gavrd7/MakerVault-Hardware/THIRD_PARTY_NOTICES.md

# Third-party code and asset notices

## MakerVault-owned source

MakerVault-authored source code and documentation in this repository are offered under the **GNU Affero General Public License, version 3 (AGPL-3.0)**. See [LICENSE](LICENSE).

This does not override third-party copyright or licensing.

## QRCode library — MIT

The bundled `qrcode.c` and `qrcode.h` are from [Richard Moore's QRCode](https://github.com/ricmoo/QRCode), incorporating contributions attributed to Project Nayuki, under the MIT licence.

The full notice is retained in [QRCode-LICENSE.txt](firmware/rfid-terminal/third_party/QRCode-LICENSE.txt) and must accompany redistributions. MIT-licensed source may be redistributed as part of an AGPL project while retaining its own original notice.

## Arduino library and board dependencies

The firmware uses external libraries/cores installed separately through Arduino IDE. Their licences are **not** changed by this repository's AGPL licence. See [build instructions](firmware/rfid-terminal/BUILD.md).

## MakerVault artwork and enclosure models

The project maintainer confirms that the MakerVault logo was created specifically for MakerVault using ChatGPT, and that the enclosure design files and UI graphics in this repository were created for this project. No third-party icon packs or external artwork are knowingly included. These assets are distributed with the project under the stated licence to the extent the maintainer has rights to grant; this statement is not a guarantee of exclusive copyright in AI-generated content.

If externally sourced material is introduced in future, identify its source and licence separately before redistribution.
