gavrd7/MakerVault-Hardware/hardware/rfid-terminal/3MF/MakerVault_flush_wordmark_3color_revC.3mf

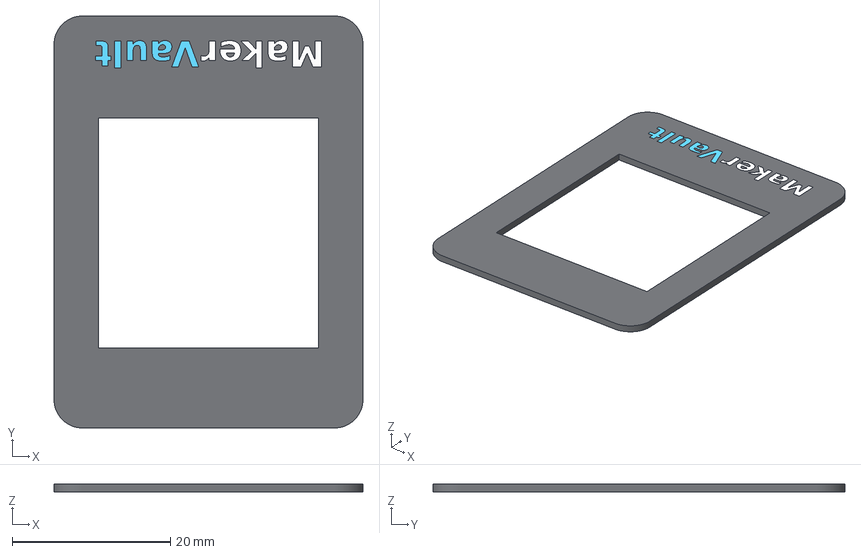
[picture p1: CAD file, 2026-10-25]
hardware/rfid-terminal/3MF/MakerVault_flush_wordmark_3color_revC.3mf
39.0 x 52.0 x 1.00 mm
flush_bezel_black
wordmark_white_Maker
wordmark_blue_Vault
