gavrd7/MakerVault-Hardware/hardware/rfid-terminal/STEPs/Bezel_3_Color_Components/flush_bezel_black.step

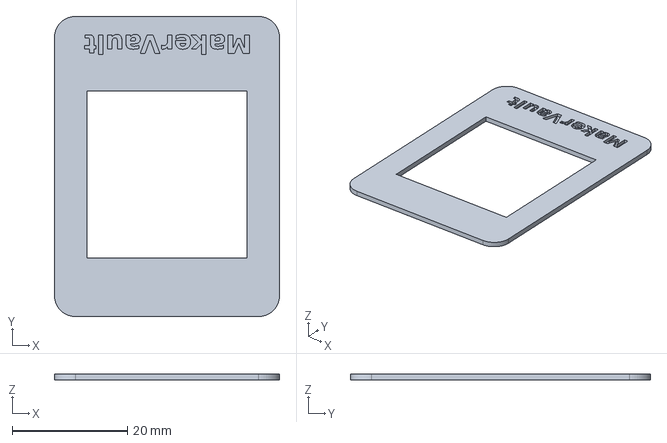
[picture p2: CAD file, 2026-10-25]
hardware/rfid-terminal/STEPs/Bezel_3_Color_Components/flush_bezel_black.step
39.0 x 52.0 x 1.00 mm
