gavrd7/MakerVault-Hardware/hardware/rfid-terminal/STEPs/display_carrier_revC.step

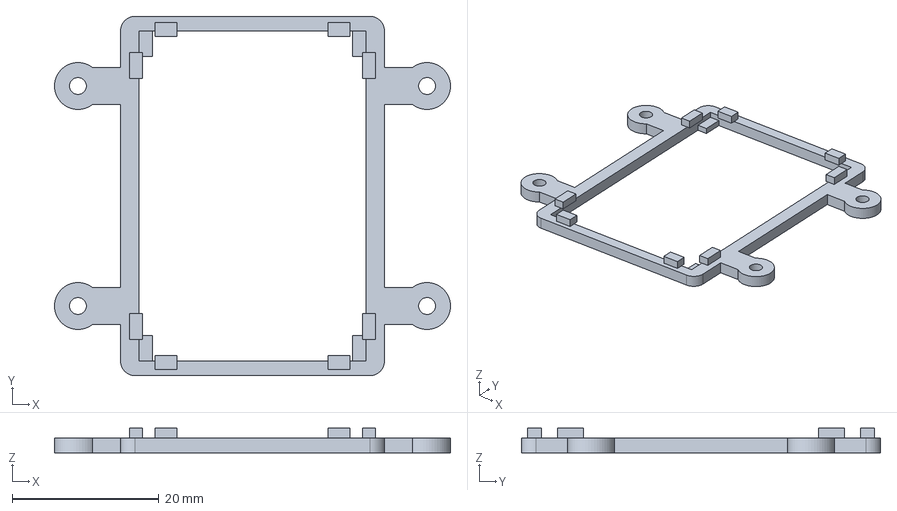
[picture p3: CAD file, 2026-10-25]
hardware/rfid-terminal/STEPs/display_carrier_revC.step
54.0 x 49.0 x 3.35 mm
