gavrd7/MakerVault-Hardware/hardware/rfid-terminal/STLs/Optional/switch_shim_0p4_revD.stl

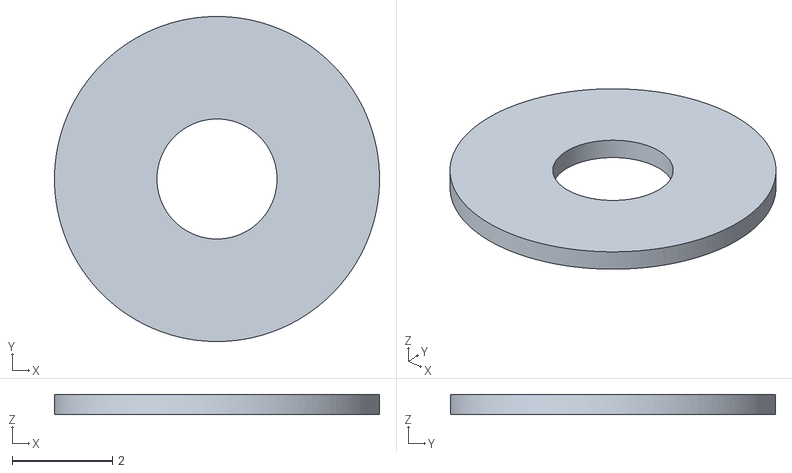
[picture p4: CAD file, 2026-10-25]
hardware/rfid-terminal/STLs/Optional/switch_shim_0p4_revD.stl
6.50 x 6.50 x 0.4
