gavrd7/MakerVault-Hardware/hardware/rfid-terminal/STEPs/Bezel_3_Color_Components/wordmark_white_Maker.step

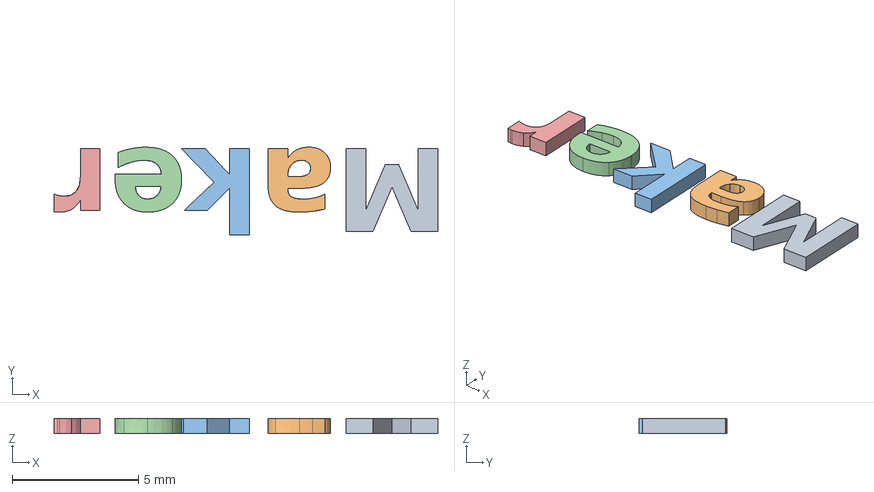
[picture p5: CAD file, 2026-10-25]
hardware/rfid-terminal/STEPs/Bezel_3_Color_Components/wordmark_white_Maker.step
15.2 x 3.48 x 0.6 mm
