gavrd7/MakerVault-Hardware/hardware/rfid-terminal/STEPs/encoder_knob_RevD.step

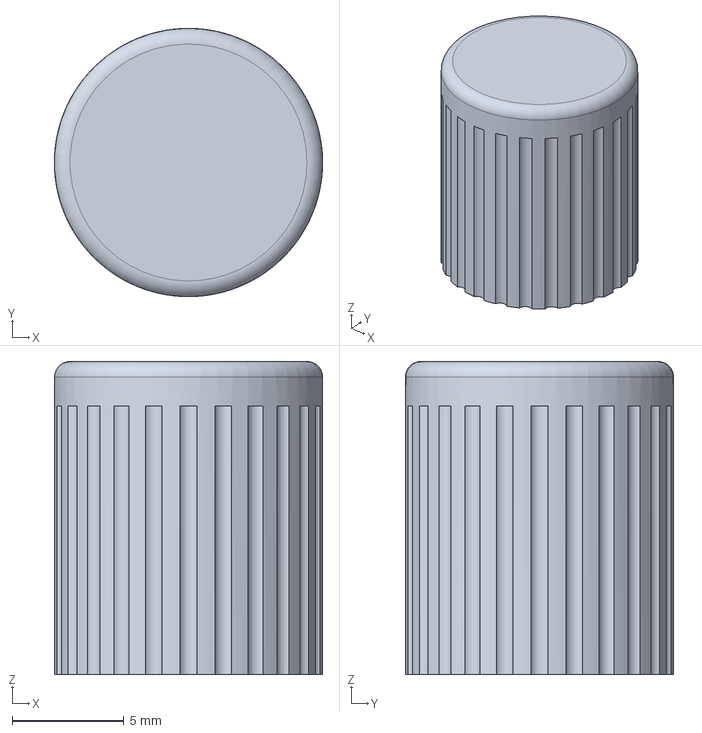
[picture p6: CAD file, 2026-10-25]
hardware/rfid-terminal/STEPs/encoder_knob_RevD.step
12.0 x 12.0 x 14.0 mm
