gavrd7/MakerVault-Hardware/hardware/rfid-terminal/STEPs/Bezel_3_Color_Components/wordmark_blue_Vault.step

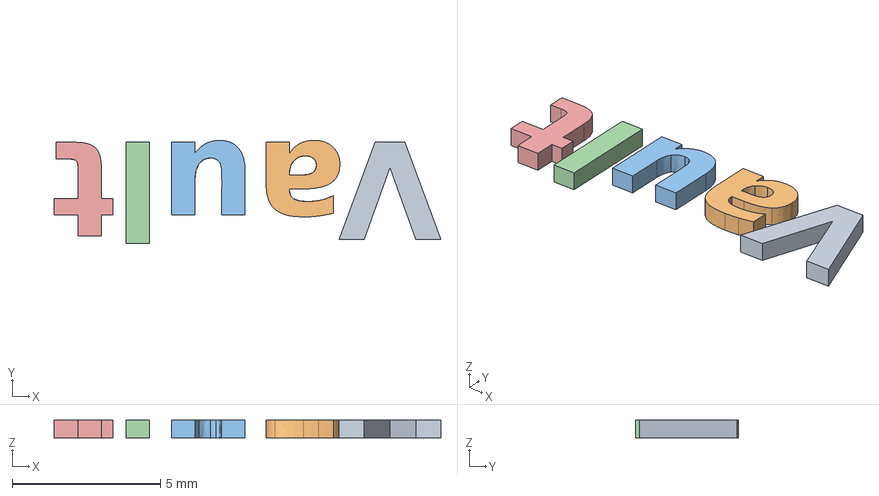
[picture p8: CAD file, 2026-10-25]
hardware/rfid-terminal/STEPs/Bezel_3_Color_Components/wordmark_blue_Vault.step
13.0 x 3.48 x 0.6 mm
