gavrd7/MakerVault-Hardware/hardware/rfid-terminal/STEPs/rear_shell_esp32_cradle_revC_m2.step

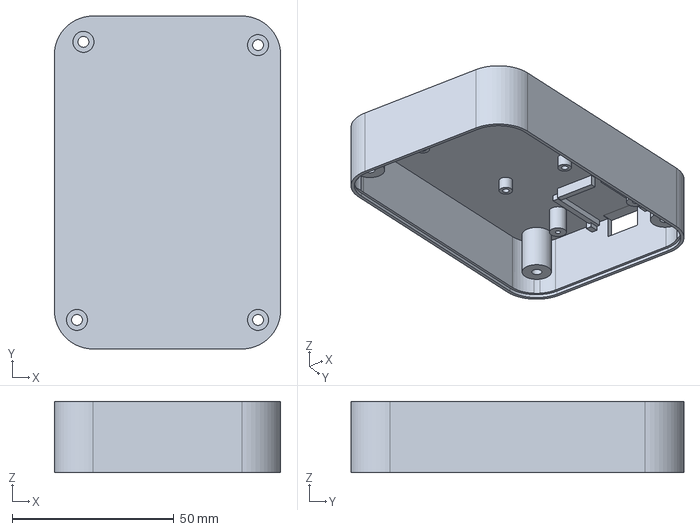
[picture p9: CAD file, 2026-10-25]
hardware/rfid-terminal/STEPs/rear_shell_esp32_cradle_revC_m2.step
70.0 x 103.0 x 22.0 mm
