gavrd7/MakerVault-Hardware/hardware/rfid-terminal/STEPs/usb_stop_bridge_revC_m2.step

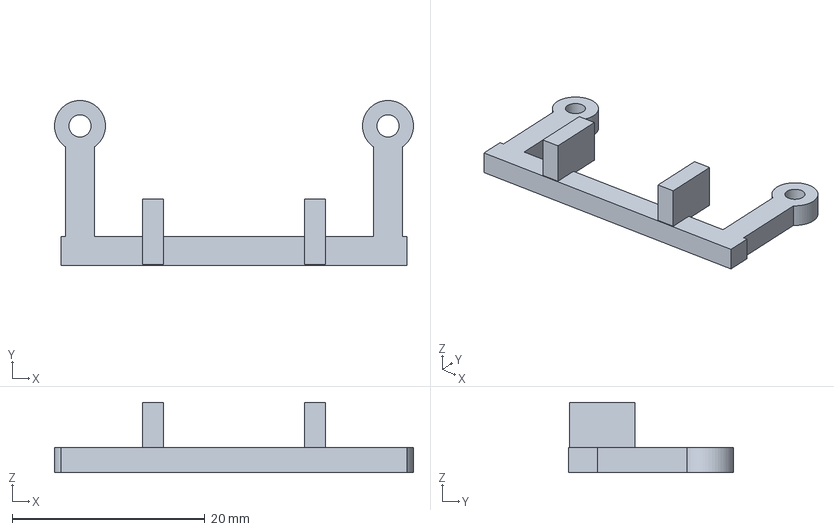
[picture p10: CAD file, 2026-10-25]
hardware/rfid-terminal/STEPs/usb_stop_bridge_revC_m2.step
37.3 x 17.1 x 7.30 mm
