gavrd7/MakerVault-Hardware/hardware/rfid-terminal/STEPs/front_shell_fastening_revC.step

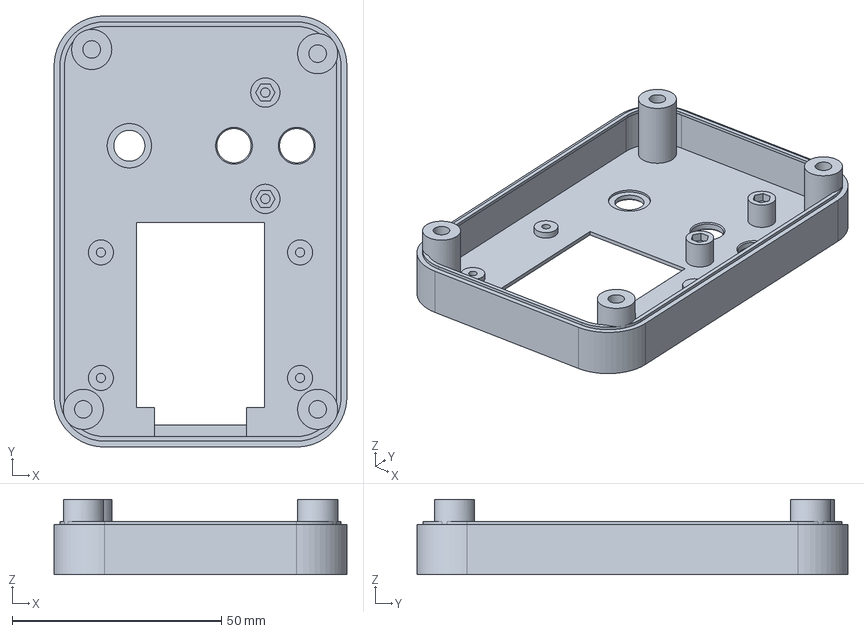
[picture p11: CAD file, 2026-10-25]
hardware/rfid-terminal/STEPs/front_shell_fastening_revC.step
70.0 x 103.0 x 18.0 mm
