gavrd7/MakerVault-Hardware/hardware/rfid-terminal/STEPs/open_switch_carrier_revE.step

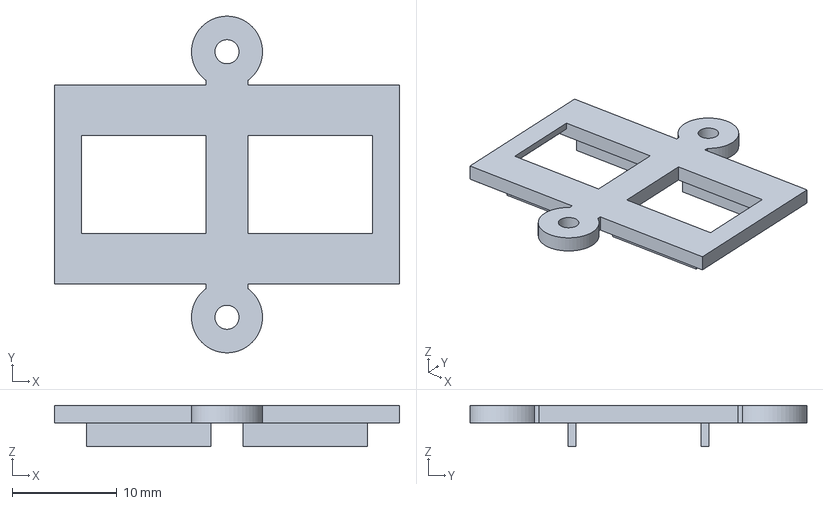
[picture p12: CAD file, 2026-10-25]
hardware/rfid-terminal/STEPs/open_switch_carrier_revE.step
33.0 x 32.2 x 3.95 mm
