gavrd7/MakerVault-Hardware/hardware/rfid-terminal/STEPs/button_cap_revD.step

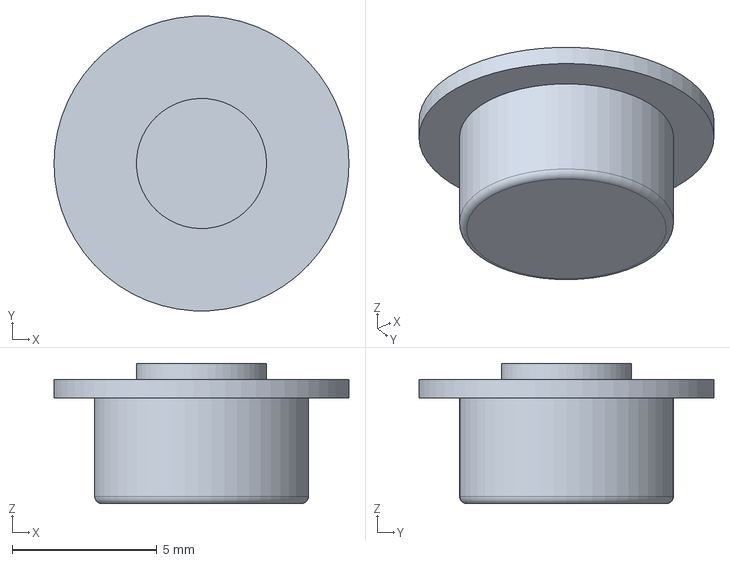
[picture p13: CAD file, 2026-10-25]
hardware/rfid-terminal/STEPs/button_cap_revD.step
10.2 x 10.2 x 4.85 mm
