gavrd7/MakerVault-Hardware/(list of files, cad)

Other CAD files:
hardware/rfid-terminal/STLs/Bezel_3_Color_Components/flush_bezel_black.stl
hardware/rfid-terminal/STLs/Bezel_3_Color_Components/wordmark_blue_Vault.stl
hardware/rfid-terminal/STLs/Bezel_3_Color_Components/wordmark_white_Maker.stl
hardware/rfid-terminal/STLs/button_cap_revD.stl
hardware/rfid-terminal/STLs/display_carrier_revC.stl
hardware/rfid-terminal/STLs/encoder_knob_RevD.stl
hardware/rfid-terminal/STLs/front_shell_fastening_revC.stl
hardware/rfid-terminal/STLs/open_switch_carrier_revE.stl
hardware/rfid-terminal/STLs/rear_shell_esp32_cradle_revC_m2.stl
hardware/rfid-terminal/STLs/usb_stop_bridge_revC_m2.stl
