gavrd7/MakerVault-Hardware/firmware/rfid-terminal/MakerVault_Terminal_Firmware/MakerVault_Terminal_Firmware.ino

#include <Arduino.h>
#include <SPI.h>
#include <Adafruit_GFX.h>
#include <Adafruit_ST7735.h>
#include <Adafruit_NeoPixel.h>
#include <MFRC522.h>
#include <WiFi.h>
#include <Fonts/FreeSansBold9pt7b.h>
#include <Fonts/FreeSansBold18pt7b.h>
#include "firmware_version.h"
#include "brand_images.h"
#include "ui_icons.h"
#include "provisioning.h"
#include "connected_registration.h"
#include "terminal_record_browser.h"
#include "scan_lookup.h"
#include "cfs_tag_reader.h"
#include "elegoo_tag_reader.h"
#include "bambu_tag_reader.h"
#include "cfs_material_labels.h"
#include "cfs_spool_lookup.h"
#include "remote_lookup.h"
#include "ntag215_feature_gate.h"
// NTAG215 NFC link writing is enabled in standard v0.7 builds.
#if MAKERVAULT_NDEF_WRITER_ENABLED
#include "connected_ndef_write.h"
#include "connected_makertag_operation.h"
#endif
#include "terminal_pending_work.h"
#include "memory_recovery_policy.h"

// MakerVault handheld UI v0.8 development -- ESP32-S3 SuperMini, Rev C.3
// Shared hardware SPI, read-only RFID, all original GPIO assignments.
constexpr uint8_t SCK_PIN=12, MOSI_PIN=11, MISO_PIN=13;
constexpr uint8_t TFT_CS=1, TFT_DC=2, TFT_RST=43;
constexpr uint8_t RFID_CS=10, RFID_RST=9;
constexpr uint8_t ENC_A=4, ENC_B=5, ENC_SW=6;
constexpr uint8_t BACK_PIN=7, CONFIRM_PIN=8, RGB_PIN=48;
Adafruit_ST7735 tft(&SPI,TFT_CS,TFT_DC,TFT_RST);
Adafruit_GFX *display = &tft; // Hardware TFT; no temporary screenshot buffer
MFRC522 rfid(RFID_CS,RFID_RST);
Adafruit_NeoPixel led(1,RGB_PIN,NEO_GRB+NEO_KHZ800);

// RGB565 palette, crafted for a small TFT.
constexpr uint16_t BG=0x0843, CARD=0x10C6, NAVY=0x10ED,
  BLUE=0x159F, SKY=0x867F, WHITE=0xFFFF, SILVER=0xCE79,
  MUTED=0x94D2, GREEN=0x464C, AMBER=0xF5A2, LINE=0x296A;

// Development MakerTag creation uses the server-authorised registration/NDEF
// lifecycle; generic RFID writing remains intentionally unavailable.
// This feature branch enables the new MakerTag browser for staged hardware
// testing. The released main-branch v0.7 firmware remains unchanged.
constexpr bool MAKERTAG_CREATE_IMPLEMENTED=true, RFID_WRITE_IMPLEMENTED=false;
enum Page:uint8_t{HOME,SCAN,RECENT,CONTROLS,INFO,CONNECTIONS,SETUP_WIFI,KNOWN_WIFI,DELETE_WIFI,MAKERVAULT_SETUP,MV_STATUS,MV_RECONNECT,MV_PAIR,MAKERTAGS_MENU,RFID_MENU,UNAVAILABLE,WIFI_MENU,MV_MENU,MV_FORGET,WIFI_STATUS,MV_TLS_TEST,MV_CA_REMOVE,REGISTRATION,LOOKUP_REQUEST,NDEF_WRITE,TAG_OPERATION,RB_CATEGORIES,RB_LIST,RB_LETTER,RB_PREVIEW};
Page page=HOME;
const char* choices[]={"MakerTags","RFID Tags","Connections","System info"};
int subSelected=0, detailScroll=0, detailCount=0;
String unavailableTitle="";
int selected=0;
int connSelected=0,networkSelected=0;
int wifiSelected=0,mvSelected=0;
uint8_t shownWifiState=255,shownMvState=255;uint32_t footerChecked=0;
String pendingDeleteSSID="";
// Persist manual offline mode independently of remembered SSIDs.

bool scanResultVisible=false, hasScanned=false, knownReader=false;
// The physical reader is shared, but each menu has distinct result semantics.
bool scanMakerTagsMode=true;
// CFS material preview is read-only and shown only in the generic RFID scan.
bool cfsDetected=false;
bool elegooDetected=false;
bool bambuDetected=false;
BambuTag::Material bambuMaterial={};
ElegooTag::Material elegooMaterial={};
CfsTag::Material cfsMaterial={};
uint8_t versionReg=0;
String recentUid="", recentType="";
uint32_t lastPoll=0,feedbackUntil=0;
bool readerInitDone=false; bool readerBusVerified=false; uint32_t bootAt=0;
uint32_t lastInputAt=0;
const int8_t decode[16]={0,-1,1,0,1,0,0,-1,-1,0,0,1,0,1,-1,0};
uint8_t previousAB=0;
int8_t stepCount=0;
uint32_t lastEncoderTurnAt=0;

struct Key {
 uint8_t pin; bool raw=true,stable=true;uint32_t changed=0;
 void begin(uint8_t p){pin=p;pinMode(pin,INPUT_PULLUP);raw=stable=digitalRead(pin);changed=millis();}
 bool pressed(){bool next=digitalRead(pin);if(next!=raw){raw=next;changed=millis();}
   if((uint32_t)(millis()-changed)>=35 && next!=stable){stable=next;return !stable;}return false;}
};
Key selectKey,backKey,confirmKey;

void asset(int x,int y,const uint16_t* image,int w,int h){display->drawRGBBitmap(x,y,image,w,h);}
void textAt(int x,int y,const char* label,uint16_t color,uint8_t size=1){
 display->setTextWrap(false);display->setTextSize(size);display->setTextColor(color);display->setCursor(x,y);display->print(label);
}
void bottom(const char* hint){
 display->fillRect(0,114,128,14,BG);display->drawFastHLine(5,113,118,LINE);
 textAt(7,118,hint,MUTED);
}
void header(const char* label){
 display->fillRect(0,0,128,24,BG);
 display->fillRoundRect(5,4,20,20,3,WHITE);
 asset(5,4,SMALL_ICON,20,20);
 textAt(31,8,label,WHITE);
 display->drawFastHLine(5,26,118,LINE);
}
void splash(){
  display->fillScreen(BG);
  // Layout is fixed to the visible 128 x 128 ST7735 viewport.
  // Leave distinct vertical bands for the logo, name and subtitle.
  display->fillRoundRect(27,3,74,74,7,WHITE);
  asset(29,5,BRAND_ICON,70,70);

  const char* first="Maker";
  const char* second="Vault";
  display->setFont(&FreeSansBold9pt7b);
  display->setTextSize(1);
  int16_t ax,ay,bx,by;
  uint16_t aw,ah,bw,bh;
  display->getTextBounds(first,0,0,&ax,&ay,&aw,&ah);
  display->getTextBounds(second,0,0,&bx,&by,&bw,&bh);
  const int16_t total=(int16_t)aw+(int16_t)bw;
  const int16_t x=(128-total)/2;
  const int16_t baseline=96;
  if(total<=122){
    display->setTextColor(WHITE);
    display->setCursor(x-ax,baseline);
    display->print(first);
    display->setTextColor(SKY);
    display->setCursor(x+(int16_t)aw-bx,baseline);
    display->print(second);
  }else{
    // Unexpected font metrics: use the native 6x8 font rather than crop.
    display->setFont(NULL);
    const int16_t nativeX=(128-10*6)/2;
    textAt(nativeX,85,first,WHITE);
    textAt(nativeX+5*6,85,second,SKY);
  }
  display->setFont(NULL);
  // 19 characters in Adafruit's default 6px font = 114px.
  // Derive the origin from measured bounds rather than a fixed X.
  const char* subtitle="RFID / NFC TERMINAL";
  int16_t sx,sy;uint16_t sw,sh;
  display->setTextSize(1);
  display->getTextBounds(subtitle,0,0,&sx,&sy,&sw,&sh);
  textAt((128-(int16_t)sw)/2-sx,107,subtitle,MUTED);
  display->drawRoundRect(18,120,92,4,2,LINE);
  display->fillRoundRect(19,121,90,2,1,BLUE);
  delay(380);
}

// Material-inspired raster assets are the sole icon source. Tint the 15x15
// status icons without restoring the old pixel-art line drawings.
// The source artwork uses a dark background and light foreground. Preserve
// antialiased edge coverage by scaling the requested RGB565 status colour.
void tintedIcon(int x,int y,const uint16_t* pixels,int width,int height,uint16_t tint){
 const uint8_t tr=((tint>>11)&31),tg=((tint>>5)&63),tb=(tint&31);
 for(int j=0;j<height;j++)for(int i=0;i<width;i++){
  uint16_t px=pgm_read_word(pixels+j*width+i);
  // Icon pixel brightness: near-background becomes transparent.
  uint8_t r=(px>>11)&31,g=(px>>5)&63,b=px&31;
  int coverage=max((int)r*2,max((int)g,(int)b*2))-6;
  if(coverage<0)coverage=0;
  if(coverage>58)coverage=58;
  if(coverage>2){
   const int br=(BG>>11)&31,bg=(BG>>5)&63,bb=BG&31;
   uint16_t out=(((br*(58-coverage)+tr*coverage)/58)<<11)|
                (((bg*(58-coverage)+tg*coverage)/58)<<5)|
                 ((bb*(58-coverage)+tb*coverage)/58);
   display->drawPixel(x+i,y+j,out);
  }
 }
}
void wifiStatusIcon(int x,int y,uint16_t c){tintedIcon(x,y,MV_WIFI_FOOTER,15,15,c);}
void mvStatusIcon(int x,int y,uint16_t c){tintedIcon(x,y,MV_SERVER_FOOTER,15,15,c);}
void centeredAt(int y,const char *label,uint16_t color){
 int16_t x0,y0;uint16_t w,h;
 display->getTextBounds(label,0,y,&x0,&y0,&w,&h);
 textAt((128-(int)w)/2-x0,y,label,color);
}
// Shared text layout: word wrap, character fallback for URLs, and scrollable details.
// Content occupies y=31..109; top header and bottom navigation remain fixed.
const int CONTENT_TOP=32, CONTENT_BOTTOM=109, ROW_H=12, MAX_LINES=64;
struct DetailLine {String content;uint16_t ink;};
DetailLine detailLines[MAX_LINES];
void detailClear(){detailCount=0;}
void detailLine(const String &line,uint16_t color){
 if(detailCount<MAX_LINES)detailLines[detailCount++]={line,color};
}
void detailWrapped(const String &raw,uint16_t color,int width=114){
 String word="",line="";
 auto flushWord=[&](){
  if(!word.length())return;
  while(word.length()){
   String candidate=line+word;int16_t xx,yy;uint16_t ww,hh;
   display->setTextSize(1);display->getTextBounds(candidate.c_str(),0,0,&xx,&yy,&ww,&hh);
   if(ww<=width){line=candidate;word="";break;}
   if(line.length()){detailLine(line,color);line="";continue;}
   String chunk="";
   while(word.length()){
    String test=chunk+word[0];display->getTextBounds(test.c_str(),0,0,&xx,&yy,&ww,&hh);
    if(ww>width && chunk.length())break;
    chunk+=word[0];word.remove(0,1);
   }
   detailLine(chunk,color);
  }
 };
 for(size_t i=0;i<raw.length();i++){
  char ch=raw[i];
  if(ch=='\n'){flushWord();detailLine(line,color);line="";continue;}
  if(ch==' '){flushWord();if(line.length())line+=' ';}else word+=ch;
 }
 flushWord();if(line.length())detailLine(line,color);
}
void detailPaint(const char* title,bool full=true){
 if(full){display->fillScreen(BG);header(title);}
 else display->fillRect(0,CONTENT_TOP,128,CONTENT_BOTTOM-CONTENT_TOP+1,BG);
 const int visible=(CONTENT_BOTTOM-CONTENT_TOP)/ROW_H;
 int maxScroll=max(0,detailCount-visible);
 detailScroll=constrain(detailScroll,0,maxScroll);
 for(int i=0;i<visible && i+detailScroll<detailCount;i++){
  int y=CONTENT_TOP+i*ROW_H;
  textAt(6,y,detailLines[i+detailScroll].content.c_str(),detailLines[i+detailScroll].ink);
 }
 if(maxScroll){
  display->drawFastVLine(124,CONTENT_TOP,CONTENT_BOTTOM-CONTENT_TOP,LINE);
  int thumb=max(8,(CONTENT_BOTTOM-CONTENT_TOP)*visible/detailCount);
  int yy=CONTENT_TOP+(CONTENT_BOTTOM-CONTENT_TOP-thumb)*detailScroll/maxScroll;
  display->fillRoundRect(123,yy,4,thumb,2,SKY);
 }
 bottom(page==NDEF_WRITE && ndefState==9 ? "Back        Confirm" : (maxScroll?"Turn: scroll  Back":"Back: menu"));
}
void detailMove(int direction,const char* title){
 int visible=(CONTENT_BOTTOM-CONTENT_TOP)/ROW_H;
 int newScroll=constrain(detailScroll+direction,0,max(0,detailCount-visible));
 if(newScroll==detailScroll)return;
 detailScroll=newScroll;detailPaint(title,false);
}
void categoryRow(int i,const char* label){
 int y=42+i*29;
 display->fillRect(4,y,120,26,BG);
 if(!label[0])return;
 display->fillRoundRect(5,y,118,25,5,i==subSelected?NAVY:CARD);
 if(i==subSelected)display->fillRoundRect(5,y+4,3,17,1,SKY);
 textAt(13,y+9,label,i==subSelected?WHITE:SILVER);
}
void categoryPage(const char* title,const char* first,const char* second){
 display->fillScreen(BG);header(title);
 const char* labels[]={first,second};
 for(int i=0;i<2;i++){
  if(!labels[i][0])continue; // hide scoped actions until supported and granted
  categoryRow(i,labels[i]);
 }
 bottom("OK: open Back: home");
}
void menuGlyph(int idx,int x,int y,bool active){
 const uint16_t* iconsA[]={MV_SCAN_ACTIVE,MV_RECENT_ACTIVE,MV_CONNECTIONS_ACTIVE,MV_INFO_ACTIVE};
 const uint16_t* iconsB[]={MV_SCAN_INACTIVE,MV_RECENT_INACTIVE,MV_CONNECTIONS_INACTIVE,MV_INFO_INACTIVE};
 asset(x,y,active?iconsA[idx]:iconsB[idx],16,16);
}
void menuItem(int index){
 int y=32+index*20;bool active=index==selected;
 display->fillRect(3,y,122,19,BG);
 display->fillRoundRect(4,y,120,18,4,active?NAVY:CARD);
 if(active)display->fillRoundRect(4,y+3,3,12,1,SKY);
 menuGlyph(index,12,y+1,active);
 textAt(35,y+6,choices[index],active?WHITE:SILVER);
 if(active){display->drawLine(113,y+6,117,y+9,SKY);display->drawLine(117,y+9,113,y+12,SKY);}
}
bool readerReady(){return readerBusVerified || hasScanned;}
const char* readerLabel(){
 if(readerReady())return "Reader ready";
 if(readerInitDone)return "Reader check";
 return "Starting reader";
}
void home(){
 display->fillScreen(BG);header("MakerVault");
 for(int i=0;i<4;i++)menuItem(i);
 // Bottom bar: only the three status icons and short labels; no clipping.
 display->fillRect(0,113,128,15,BG);display->drawFastHLine(5,112,118,LINE);
 display->fillCircle(8,121,3,readerReady()?GREEN:(readerInitDone?AMBER:MUTED));
 textAt(14,118,"RFID",SILVER);
 // Live, colour-coded icons. The older bitmap artwork was permanently grey.
 wifiStatusIcon(51,113,WiFi.status()==WL_CONNECTED?GREEN:(knownCount?AMBER:MUTED));
 mvStatusIcon(86,113,mvCheckState==3?GREEN:(mvCheckState==2?AMBER:(mvCheckState==4?0xF800:MUTED)));
 // Connection details live in the Connections screen.
 shownWifiState=255;shownMvState=255;
}
void refreshFooter(){
 if(page!=HOME)return;
 uint8_t wifiState=WiFi.status()==WL_CONNECTED?2:(knownCount?1:0);
 uint8_t mvState=mvCheckState;
 if(wifiState==shownWifiState && mvState==shownMvState)return;
 shownWifiState=wifiState;shownMvState=mvState;
 display->fillRect(49,113,17,15,BG);display->fillRect(84,113,17,15,BG);
 wifiStatusIcon(51,113,wifiState==2?GREEN:(wifiState==1?AMBER:MUTED));
 mvStatusIcon(86,113,mvState==3?GREEN:(mvState==2?AMBER:(mvState==4?0xF800:MUTED)));
}
void simple(const char* title,const char* line1,const char* line2=""){
 display->fillScreen(BG);header(title);
 display->fillRoundRect(7,36,114,62,7,CARD);
 textAt(13,54,line1,WHITE);
 if(line2[0])textAt(13,72,line2,MUTED);
 bottom("Back: menu");
}
// Draw a prominent record identity, then the MakerVault ID; UID is secondary.
// Declared here because the scan screen reuses the record name wrapping helper.
int regWrapLines(const String &source, String *lines);
// Keep tag identity fields within the 128px viewport. Two short rows
// accommodate long MFRC522 family names without clipping or truncating UID.
void scanTypeWrapped(int y, uint16_t color){
 String value=recentType;
 const int maxChars=19; // 128px - 14px margins, 6px per character
 if(value.length()<=maxChars){centeredAt(y,value.c_str(),color);return;}
 int split=value.lastIndexOf(' ',maxChars);
 if(split<6)split=maxChars;
 String first=value.substring(0,split);
 String second=value.substring(split);
 second.trim();
 centeredAt(y,first.c_str(),color);
 if(second.length()>maxChars)second=second.substring(0,maxChars-1)+"~";
 centeredAt(y+12,second.c_str(),color);
}
void scanPage(){
 display->fillScreen(BG);
 if(!scanResultVisible){
  header(scanMakerTagsMode?"Scan MakerTag":"Scan RFID Tag");
  display->fillRoundRect(9,32,110,76,9,CARD);
  display->drawRoundRect(9,32,110,76,9,BLUE);
  asset(41,37,MV_SCAN_LARGE,46,46);
  centeredAt(78,"READY TO SCAN",WHITE);
  centeredAt(92,scanMakerTagsMode?"Present MakerTag":"Present RFID tag",SKY);
  bottom("Back: menu");return;
 }
 header(scanMakerTagsMode?"MakerTag scan":(cfsDetected?"CFS material":elegooDetected?"Elegoo (test)":bambuDetected?"Bambu (test)":"RFID scan"));
 if(!scanMakerTagsMode && bambuDetected){
  centeredAt(35,bambuMaterial.material,WHITE);
  centeredAt(49,bambuMaterial.detail,WHITE);
  display->fillRoundRect(42,58,44,11,4,CfsTag::hexRgb565(bambuMaterial.color));
  display->drawRoundRect(42,58,44,11,4,WHITE);
  centeredAt(79,(String("#")+bambuMaterial.color).c_str(),SKY);
  centeredAt(91,(String(bambuMaterial.weightGrams)+"g / "+bambuMaterial.materialId).c_str(),SILVER);
  centeredAt(103,recentUid.substring(0,19).c_str(),SILVER);
  bottom("Experimental / UID");return;
 }
 if(!scanMakerTagsMode && elegooDetected){
  centeredAt(38,(String(elegooMaterial.material)+" "+elegooMaterial.subtype).c_str(),WHITE);
  display->fillRoundRect(42,52,44,11,4,CfsTag::hexRgb565(elegooMaterial.color));
  display->drawRoundRect(42,52,44,11,4,WHITE);
  centeredAt(73,(String("#")+elegooMaterial.color).c_str(),SKY);
  centeredAt(88,(String(elegooMaterial.weightGrams)+"g / "+
             String(elegooMaterial.diameterHundredths/100.0f,2)+"mm").c_str(),SILVER);
  centeredAt(103,recentUid.substring(0,19).c_str(),SILVER);
  bottom("Experimental / UID");return;
 }
 if(!scanMakerTagsMode && cfsDetected){
  // Name comes from MakerVault; offline we display only data decoded from the tag.
  if(cfsMaterialLookupState==2 && cfsMaterialName.length()){
   String manufacturer=cfsMaterialManufacturer;
   if(manufacturer.length()>19)manufacturer=manufacturer.substring(0,18)+"~";
   centeredAt(31,manufacturer.c_str(),WHITE);
   String friendly=cfsMaterialName;
   if(friendly.length()>19)friendly=friendly.substring(0,18)+"~";
   centeredAt(44,friendly.c_str(),WHITE);
  }else{
   centeredAt(31,cfsMaterialLookupState==1?"Checking server...":cfsMaterialLookupState==4?"Connect for name":"Unknown material",SILVER);
   centeredAt(44,(String("ID ")+cfsMaterial.materialId).c_str(),WHITE);
  }
  // Compact, rounded rectangular swatch on one line, using the tag's actual hex.
  display->fillRoundRect(42,58,44,11,4,CfsTag::hexRgb565(cfsMaterial.color));
  display->drawRoundRect(42,58,44,11,4,WHITE);
  centeredAt(78,(String("#")+cfsMaterial.color).c_str(),SKY);
  if(cfsLookupState==2)
   centeredAt(90,(String("Spool: ")+cfsLookupSpool).substring(0,20).c_str(),GREEN);
  else if(cfsLookupState==3)centeredAt(90,"Spool not linked",AMBER);
  else if(cfsLookupState==4)centeredAt(90,"Lookup unavailable",AMBER);
  else centeredAt(90,"Checking spool...",SILVER);
  centeredAt(102,recentUid.substring(0,19).c_str(),SILVER);
  bottom("Confirm: rescan");return;
 }
 if(!scanMakerTagsMode && scanLookupState==2){
  centeredAt(55,"MakerTag found",GREEN);
  centeredAt(75,"Use Scan MakerTag",SKY);
 }else if(scanLookupState==2){
  String nameLines[20];
  int count=regWrapLines(scanLookupName,nameLines);
  int maxLines=min(3,count);
  for(int i=0;i<maxLines;i++)textAt(7,36+i*13,nameLines[i].c_str(),WHITE);
  // The full identifier must fit: MV- plus eight hex chars.
  textAt(7,79,scanLookupCode.c_str(),SKY);
 }else if(scanLookupState==3 && !scanMakerTagsMode){
  centeredAt(45,"RFID detected",GREEN);
  scanTypeWrapped(61,WHITE);
  centeredAt(84,"Not a MakerTag",SILVER);
 }else if(scanLookupState==3){
  // Material-style unknown identity: filled amber status disc with a
  // high-contrast white help glyph, rather than an outlined circle.
  display->fillCircle(64,48,16,AMBER);
  textAt(58,40,"?",WHITE,2);
  // Restore normal text size before centeredAt measures the label bounds.
  display->setTextSize(1);
  centeredAt(73,"Not MakerTag",AMBER);
 }else if(scanLookupState==1){
  centeredAt(62,"Checking tag...",SKY);
 }else if(scanLookupState==4){
  centeredAt(48,"Lookup unavailable",AMBER);
  if(!scanMakerTagsMode)scanTypeWrapped(63,SILVER);
 }else{
  centeredAt(37,"TAG READ",GREEN);
  scanTypeWrapped(60,SILVER);
 }
 // UID remains visible, small and lower priority.
 textAt(7,97,recentUid.substring(0,19).c_str(),SILVER);
 bottom("Confirm: rescan");
}
void remoteLookupScreen(){
 display->fillScreen(BG);header("Find MakerTag");
 if(remoteLookupState==1){
  centeredAt(48,"Request received",GREEN);
  centeredAt(68,"Present a tag",SKY);
  bottom("Back: dismiss");
 }else if(remoteLookupState==2){
  centeredAt(60,"Looking up...",SKY);
  bottom("Please wait");
 }else if(remoteLookupState==3){
  centeredAt(48,"Lookup complete",GREEN);
  centeredAt(68,"Check MakerVault",SKY);
  bottom("Back: menu");
 }else{
  centeredAt(48,"Lookup failed",AMBER);
  textAt(7,71,remoteLookupError.substring(0,19).c_str(),SILVER);
  bottom("Back: menu");
 }
}
void connectionRow(int i){
 const char* menu[]={"Wi-Fi","MakerVault"};
 {
  int y=43+i*31;
  display->fillRect(5,y,118,27,BG);
  display->fillRoundRect(6,y,116,26,4,i==connSelected?NAVY:CARD);
  if(i==connSelected)display->fillRoundRect(6,y+3,3,20,1,SKY);
  if(i==0)wifiStatusIcon(11,y+4,WiFi.status()==WL_CONNECTED?GREEN:AMBER);
  else mvStatusIcon(11,y+4,mvPairVerified&&mvCheckState==3?GREEN:(mvCheckState==4?0xF800:AMBER));
  textAt(38,y+9,menu[i],i==connSelected?WHITE:SILVER);
 }
}
void connections(){
 display->fillScreen(BG);header("Connections");
 for(int i=0;i<2;i++)connectionRow(i);
 bottom("OK: open Back: home");
}
const int WIFI_MENU_COUNT=5;
const char* wifiOption(int i){
 if(i==0)return wifiManualOffline?"Connect":(WiFi.status()==WL_CONNECTED?"Disconnect":"Connect");
 if(i==1)return "Connection status";
 if(i==2)return "Known networks";
 if(i==3)return "Add network";
 return "Reconnect";
}
void wifiRow(int i){
 int y=51+i*12;
 display->fillRect(5,y,118,12,BG);
 if(i==wifiSelected)display->fillRoundRect(5,y,118,12,3,NAVY);
 textAt(10,y+2,wifiOption(i),i==wifiSelected?WHITE:SILVER);
}
void wifiMenu(){
 display->fillScreen(BG);header("Wi-Fi");
 textAt(7,31,wifiManualOffline?"Manually offline":(WiFi.status()==WL_CONNECTED?"Connected":"Offline"),WiFi.status()==WL_CONNECTED?GREEN:AMBER);
 String network=WiFi.status()==WL_CONNECTED?WiFi.SSID():"No active network";
 if(network.length()>19)network=network.substring(0,18)+"~";
 textAt(7,43,network.c_str(),SILVER);
 for(int i=0;i<WIFI_MENU_COUNT;i++)wifiRow(i);
 bottom("OK: open Back: menu");
}
// Values are read from the active Wi-Fi interface, never cached as a past lease.
String currentIpAddress(){
 return WiFi.status()==WL_CONNECTED?WiFi.localIP().toString():String("Not connected");
}
void wifiStatusPage(){
 const bool connected=WiFi.status()==WL_CONNECTED;
 detailClear();detailScroll=0;
 detailWrapped(String("Connection: ")+(connected?"Connected":(wifiManualOffline?"Manually offline":"Disconnected")),connected?GREEN:AMBER);
 detailWrapped("SSID: "+(connected?WiFi.SSID():String("Not connected")),SILVER);
 detailWrapped("IP address: "+currentIpAddress(),connected?WHITE:SILVER);
 if(connected)detailWrapped("Signal: "+String(WiFi.RSSI())+" dBm",SILVER);
 else detailWrapped("Signal: unavailable",MUTED);
 detailPaint("Wi-Fi status");
}
void makerRow(int i){
 const char* entries[]={"Connection status","Reconnect server","Test HTTPS","Pair device","Server setup","Remove CA","Forget pairing"};
 int y=29+i*12;
 display->fillRect(5,y,118,12,BG);
 if(i==mvSelected)display->fillRoundRect(5,y,118,12,3,NAVY);
 textAt(10,y+2,entries[i],i==mvSelected?WHITE:SILVER);
}
void makerMenu(){
 display->fillScreen(BG);header("MakerVault");
 for(int i=0;i<7;i++)makerRow(i);
 bottom("OK: open Back: menu");
}
void removeCaScreen(){
 display->fillScreen(BG);header("Remove custom CA?");
 centeredAt(39,mvCaPem.isEmpty()?"No custom CA":"Switch to public CA",WHITE);
 centeredAt(56,"Key is retained",SILVER);
 centeredAt(73,"Private CA won't work",AMBER);
 bottom("OK: remove Back: no");
}
void forgetPairScreen(){
 display->fillScreen(BG);header("Forget pairing?");
 centeredAt(40,"Remove local key?",WHITE);
 centeredAt(57,"Wi-Fi is retained",SILVER);
 centeredAt(76,"Use MV to revoke",AMBER);
 bottom("OK: forget Back: no");
}
void mvSettings(){
 if(lanPortalActive && WiFi.status()==WL_CONNECTED){
  String link="http://"+WiFi.localIP().toString()+"/makervault";
  QRCode code;uint8_t data[qrcode_getBufferSize(5)];
  qrcode_initText(&code,data,5,ECC_LOW,link.c_str());
  display->fillScreen(BG);
  centeredAt(3,"MAKERVAULT SETUP",WHITE);
  int scale=2;int x=(128-(code.size+8)*scale)/2,y=17;
  display->fillRect(x,y,(code.size+8)*scale,(code.size+8)*scale,WHITE);
  for(int r=0;r<code.size;r++)for(int c=0;c<code.size;c++)
   if(qrcode_getModule(&code,c,r))display->fillRect(x+(c+4)*scale,y+(r+4)*scale,scale,scale,0);
  centeredAt(105,"SCAN LAN QR",SKY);
  String addr=WiFi.localIP().toString();
  centeredAt(117,addr.c_str(),WHITE);
 }else{
  // Unconnected terminal: join its temporary AP, then open the local portal.
  drawSetupQR(*display,BG,WHITE);
  display->fillRect(0,0,128,14,BG);
  centeredAt(3,"MAKERVAULT SETUP",WHITE);
  display->fillRect(0,105,128,23,BG);
  centeredAt(106,"192.168.4.1",SKY);
  centeredAt(118,"/makervault",WHITE);
 }
}
void mvStatusPage(){
 detailClear();
 detailWrapped(WiFi.status()==WL_CONNECTED?"Wi-Fi: connected":"Wi-Fi: offline",WiFi.status()==WL_CONNECTED?GREEN:AMBER);
 detailWrapped(String("Pairing: ")+mvPairingLabel(),mvPairVerified?GREEN:AMBER);
 if(mvDeviceName.length())detailWrapped("Device: "+mvDeviceName,WHITE);
 detailWrapped(String("API: ")+mvStatusName(),mvCheckState==3?GREEN:(mvCheckState==4?0xF800:AMBER));
 detailWrapped("HTTPS: "+String(mvTlsStatus==1?"Verified":(mvTlsStatus==2?"Certificate rejected":(mvTlsStatus==3?"Failed / unknown":"Not tested"))),mvTlsStatus==1?GREEN:AMBER);
 detailWrapped("Trust: "+mvTrustMode(),SILVER);
 detailWrapped("Last OK: "+mvLastGoodConnection,SILVER);
 detailWrapped("Last error: "+mvLastConnectionError,mvTlsStatus==1?SILVER:AMBER);
 detailWrapped(String("Work API: ")+
   (pendingWorkLastCode==200?"Connected":
    pendingWorkLastCode==404?"Update MakerVault app":
    pendingWorkLastCode==403?"Scope denied":
    pendingWorkLastCode==0?"Not checked":"Retry pending"),
   pendingWorkLastCode==200?GREEN:AMBER);
 detailWrapped("Heap free: "+String(heap_caps_get_free_size(MALLOC_CAP_INTERNAL|MALLOC_CAP_8BIT))+" bytes",SILVER);
 detailWrapped("Largest block: "+String(heap_caps_get_largest_free_block(MALLOC_CAP_INTERNAL|MALLOC_CAP_8BIT))+" bytes",SILVER);
 detailWrapped("API permissions:",WHITE);
 detailWrapped(String("MakerTag read: ")+(mvCanReadTags?"Allowed":"Not granted"),mvCanReadTags?GREEN:SILVER);
 detailWrapped(String("MakerTag write: ")+(mvCanWriteTags?"Allowed":"Not granted"),mvCanWriteTags?GREEN:SILVER);
 detailWrapped(String("Inventory search: ")+(mvCanSearchInventory?"Allowed":"Not granted"),mvCanSearchInventory?GREEN:SILVER);
 detailWrapped(String("Heartbeat: ")+(mvCanHeartbeat?"Allowed":"Not granted"),mvCanHeartbeat?GREEN:SILVER);
 detailWrapped("Tag writing: not installed",MUTED);
 detailWrapped(String("Server: ")+mvBaseUrl,SILVER);
 if(mvLastHttpCode)detailWrapped("HTTP: "+String(mvLastHttpCode),mvLastHttpCode==200?GREEN:AMBER);
 detailPaint("MakerVault link");
}
void mvReconnectPage(){
 display->fillScreen(BG);header("Reconnect server");
 uint8_t phase=mvReconnectState;
 if(phase==1){
   centeredAt(35,"Refreshing Wi-Fi",SKY);
   centeredAt(58,WiFi.status()==WL_CONNECTED?"Network restored":"Joining saved Wi-Fi",SILVER);
   centeredAt(83,"Checking connection",SILVER);
 }else if(phase==2){
   centeredAt(35,"Wi-Fi connected",GREEN);
   centeredAt(59,"Verifying HTTPS",SKY);
   centeredAt(83,"Checking saved key",SILVER);
 }else if(phase==3){
   centeredAt(38,"Server connected",GREEN);
   centeredAt(61,"HTTPS verified",GREEN);
   centeredAt(83,"Pairing retained",SILVER);
 }else if(phase==4){
   centeredAt(34,"Reconnect failed",AMBER);
   String error=mvReconnectError.isEmpty()?"Check Wi-Fi / HTTPS":mvReconnectError;
   opTwoLine(error,57,WHITE);
 }else{
   centeredAt(48,"Reconnect idle",SILVER);
 }
 bottom(phase==1||phase==2?"Back: keep trying":(phase==4?"OK: retry Back":"OK: done Back"));
}
void mvPairPage(){
 display->fillScreen(BG);header("Pair device");
 if(WiFi.status()!=WL_CONNECTED)textAt(8,37,"Connect Wi-Fi first",AMBER);
 else if(!mvValidUrl(mvBaseUrl)){
  textAt(8,37,"Set HTTPS server",AMBER);textAt(8,52,"in MakerVault setup",SILVER);
 }else if(mvPairState==1){centeredAt(43,"Connecting securely",SKY);centeredAt(60,"Requesting code...",SILVER);}
 else if(mvPairState==2){
  centeredAt(38,"Enter in MakerVault",SILVER);
  display->setTextSize(2);centeredAt(59,mvPairCode.c_str(),WHITE);display->setTextSize(1);
  uint32_t elapsed=(uint32_t)(millis()-mvPairStarted);uint32_t left=elapsed>=300000?0:(300000-elapsed)/1000;
  centeredAt(88,("Expires in "+String(left)+"s").c_str(),AMBER);
 }else if(mvPairState==3){centeredAt(43, mvCheckState==3?"Connected!":"Paired",GREEN);centeredAt(64,mvCheckState==3?"MakerVault ready":"Verifying API",SILVER);}
 else if(mvPairState==4||mvPairState==5){
  centeredAt(34,"Pairing failed",AMBER);
  // Negative HTTPClient codes are not HTTP response codes. Show the
  // verified TLS failure reason rather than a misleading 'HTTP -1'.
  String error=mvPairError;
  if(error.startsWith("Start HTTP -")){
    if(mvTlsStatus==2)error="Certificate rejected";
    else if(mvLastConnectionError=="Cannot resolve server")error="DNS lookup failed";
    else if(mvLastConnectionError=="Wi-Fi offline")error="Wi-Fi disconnected";
    else if(mvLastConnectionError=="Server timeout")error="Server timed out";
    else if(mvLastConnectionError=="Clock unavailable")error="Clock unavailable";
    else error="HTTPS connection failed";
  }
  // Basic 128px display: two readable lines, with full error in Serial.
  if(error.length()>23){
    int split=error.lastIndexOf(' ',23);
    if(split<7)split=22;
    String top=error.substring(0,split);
    String rest=error.substring(split);rest.trim();
    centeredAt(57,top.c_str(),SILVER);
    if(rest.length()>23)rest=rest.substring(0,22)+"~";
    centeredAt(70,rest.c_str(),SILVER);
  }else centeredAt(61,error.c_str(),SILVER);
  centeredAt(92,"Check CA / server",MUTED);
 }
 else textAt(8,43,"Press OK to start",SILVER);
 bottom(mvPairState==3?"Back: menu":"OK: retry Back: stop");
}
void knownNetworkRow(uint8_t i){
 {
  uint8_t y=32+i*15;
  display->fillRect(6,y,116,14,BG);
  if(i==networkSelected)display->fillRoundRect(6,y,116,14,3,NAVY);
  String label=knownSSID[i];if(label.length()>17)label=label.substring(0,16)+"~";
  textAt(10,y+3,label.c_str(),WHITE);
  if(WiFi.status()==WL_CONNECTED && WiFi.SSID()==knownSSID[i])display->fillCircle(116,y+7,3,GREEN);
 }
}
void knownNetworks(){
 display->fillScreen(BG);header("Known Wi-Fi");
 if(knownCount==0)textAt(10,44,"No saved networks",MUTED);
 for(uint8_t i=0;i<knownCount;i++)knownNetworkRow(i);
 bottom("OK: join  Knob: del");
}


void deleteNetworkScreen(){
 display->fillScreen(BG);header("Forget Wi-Fi?");
 display->fillRoundRect(7,37,114,62,7,CARD);
 textAt(13,45,"Remove network?",WHITE);
 String label=pendingDeleteSSID;
 if(label.length()>18)label=label.substring(0,17)+"~";
 textAt(13,63,label.c_str(),SKY);
 textAt(13,83,"Cannot undo",AMBER);
 bottom("OK: delete  Back: no");
}
void connectKnownNetwork(){
 wifiSetManualOffline(false);
 if(!knownCount || networkSelected>=knownCount)return;
 const String ssid=knownSSID[networkSelected];
 if(WiFi.status()==WL_CONNECTED && WiFi.SSID()==ssid){
  Serial.println("[WIFI] Already connected to selected network");
  return;
 }
 Serial.print("[WIFI] Connecting to saved network: ");Serial.println(ssid);
 // Explicit connection first, before allowing the periodic fallback scanner.
 WiFi.mode(WIFI_STA);
 WiFi.disconnect();
 lastReconnectTry=millis();
 WiFi.begin(knownSSID[networkSelected].c_str(),knownPass[networkSelected].c_str());
 render();
}

void info(){
 detailClear();detailWrapped(String("Firmware v")+MAKERVAULT_FIRMWARE_VERSION,WHITE);
 detailWrapped("Device: "+(mvDeviceName.length()?mvDeviceName:String("Not verified")),SILVER);
 detailWrapped("Wi-Fi IP: "+currentIpAddress(),WiFi.status()==WL_CONNECTED?WHITE:SILVER);
 detailWrapped("Pairing: "+String(mvPairingLabel()),mvPairVerified?GREEN:AMBER);
 detailWrapped(String("API scopes: ")+(mvCheckState==3?"verified":"unknown"),mvCheckState==3?GREEN:AMBER);
 detailWrapped(String("Tag read: ")+(mvCanReadTags?"allowed":"unavailable"),mvCanReadTags?GREEN:SILVER);
 detailWrapped(String("Tag write: ")+(mvCanWriteTags?"allowed":"unavailable"),mvCanWriteTags?GREEN:SILVER);
 detailWrapped("SPI: shared hardware",SILVER);
 detailWrapped("RC522: 0x"+String(versionReg,HEX),SILVER);
 detailWrapped(readerLabel(),readerReady()?GREEN:AMBER);
 detailPaint("System info");
}
void mvTlsTestPage(){
 detailClear();
 if(mvTestRunning){
  detailWrapped("Running HTTPS test...",SKY);
  detailWrapped("No pairing changes",SILVER);
 }else{
  const int code=mvTestHttpCode;
  detailWrapped(String("Trust: ")+mvTestTrust,SILVER);
  detailWrapped(String("TCP/TLS: ")+(mvTestTlsStatus==1?"Verified":(mvTestTlsStatus==2?"Certificate rejected":"Failed / not confirmed")),mvTestTlsStatus==1?GREEN:AMBER);
  detailWrapped(String("API: ")+(code>0?mvHttpLabel(code):String("No HTTP response")),code==200?GREEN:AMBER);
  detailWrapped("Result: "+mvTestError,code==200?GREEN:AMBER);
  if(mvTestDetail.length())detailWrapped("Diagnostic: "+mvTestDetail,SILVER);
 }
 detailPaint("Test HTTPS");
}
// The ST7735S has 128x128 pixels. Default GFX text is 6px per character;
// x=7 gives room for 19 characters without touching the right edge.
constexpr int REG_TEXT_CHARS=19;
constexpr int REG_MAX_LINES=20;

// Split at word boundaries; unusually long words are broken at the margin.
// A label may exceed one screen, so page through all its lines every 4s.
int regWrapLines(const String &source, String *lines) {
 String pending=source;
 pending.trim();
 int count=0;
 while(pending.length() && count<REG_MAX_LINES) {
  int cut=min((int)pending.length(),REG_TEXT_CHARS);
  if(cut<(int)pending.length()) {
   int boundary=pending.lastIndexOf(' ',cut);
   if(boundary>0)cut=boundary;
  }
  String line=pending.substring(0,cut);
  line.trim();
  if(line.length())lines[count++]=line;
  pending=pending.substring(cut);
  pending.trim();
 }
 return count;
}

void regDisplayRecord() {
 String lines[REG_MAX_LINES];
 const int count=regWrapLines(regTarget,lines);
 const int pages=max(1,(count+2)/3);
 const int page=(millis()/4000UL)%pages;
 for(int i=0;i<3;i++) {
  int index=page*3+i;
  if(index<count)textAt(7,39+i*13,lines[index].c_str(),WHITE);
 }
 if(pages>1) {
  String indicator=String(page+1)+"/"+String(pages);
  textAt(100,29,indicator.c_str(),MUTED);
 }
 // Two lines reserved for the record ID, separate from the record name.
 if(regRecordCode.length()) {
  String code="ID: "+regRecordCode;
  textAt(7,79,code.substring(0,REG_TEXT_CHARS).c_str(),SILVER);
  if(code.length()>REG_TEXT_CHARS)
   textAt(7,90,code.substring(REG_TEXT_CHARS,REG_TEXT_CHARS*2).c_str(),SILVER);
 }
 textAt(7,103,"Present a tag",SKY);
 bottom("Back: dismiss");
}

void makerTagSuccessIcon(const char* title,const char* detail){
 display->fillScreen(BG);header("MakerTags");
 display->drawCircle(64,56,24,GREEN);
 display->drawCircle(64,56,23,GREEN);
 display->drawLine(51,56,61,66,GREEN);
 display->drawLine(61,66,78,47,GREEN);
 centeredAt(87,title,GREEN);
 centeredAt(101,detail,SILVER);
 bottom("OK: finish");
}
void registrationScreen(){
 if(regState==4){
  makerTagSuccessIcon("MakerTag assigned","UID linked");return;
 }
 display->fillScreen(BG);
 header("Assign MakerTag");
 if(regState==1) {
  regDisplayRecord();
 } else if(regState==2) {
  textAt(7,37,"Scanned UID:",SILVER);
  // 10-byte UIDs are 20 hexadecimal characters; show ALL bytes.
  textAt(7,52,regUid.substring(0,REG_TEXT_CHARS).c_str(),WHITE);
  if(regUid.length()>REG_TEXT_CHARS)
   textAt(7,65,regUid.substring(REG_TEXT_CHARS,REG_TEXT_CHARS*2).c_str(),WHITE);
  textAt(7,83,regKind=="nfc"?"Assign & write?":"Assign this tag?",SKY);
  if(regKind=="nfc")textAt(7,96,"Keep tag in place",SILVER);
  bottom(regKind=="nfc"?"OK: start Back: no":"OK: save Back: no");
 } else if(regState==6) {
  // Both names wrap at word boundaries. Long labels cycle through their
  // remaining lines rather than silently clipping the destination.
  textAt(7,30,"Already registered",AMBER);
  String oldLines[REG_MAX_LINES],newLines[REG_MAX_LINES];
  int oldCount=regWrapLines(regPreviousLabel,oldLines);
  int newCount=regWrapLines(regTarget,newLines);
  int oldPages=max(1,(oldCount+1)/2),newPages=max(1,(newCount+1)/2);
  int pageNumber=(millis()/4000UL)%max(oldPages,newPages);
  for(int i=0;i<2;i++){
   int oldIndex=(pageNumber%oldPages)*2+i;
   if(oldIndex<oldCount)textAt(7,43+i*11,oldLines[oldIndex].c_str(),WHITE);
  }
  textAt(7,66,"Reassign to:",SILVER);
  for(int i=0;i<2;i++){
   int newIndex=(pageNumber%newPages)*2+i;
   if(newIndex<newCount)textAt(7,79+i*11,newLines[newIndex].c_str(),WHITE);
  }
  bottom("OK: move Back: no");
 } else if(regState==7) {
  textAt(7,48,"Checking MakerTag",SKY);
  bottom("Keep tag in place");
 } else if(regState==3) {
  textAt(7,48,"Keep tag in place",SKY);
  textAt(7,65,"Setting up...",SILVER);
  bottom("Please wait");
 } else if(regState==4) {
  textAt(7,48,"MakerTag assigned",GREEN);
  bottom("Back: menu");
 } else {
  textAt(7,43,"Registration failed",AMBER);
  String errors[REG_MAX_LINES];
  int count=regWrapLines(regError,errors);
  for(int i=0;i<count && i<3;i++)
   textAt(7,58+i*13,errors[i].c_str(),WHITE);
  bottom("Back: menu");
 }
}
#if MAKERVAULT_NDEF_WRITER_ENABLED
void ndefWriterScreen(){
 if(ndefState==6 && ndefAutoFlow){
  makerTagSuccessIcon("MakerTag ready",ndefTagId.c_str());return;
 }
 detailClear();detailWrapped("Tag: "+ndefTagId,WHITE);
 if(ndefState==1)detailWrapped(ndefError.length()?ndefError:(ndefAutoFlow?"Keep / return same tag":"Present matching NTAG215"),ndefError.length()?AMBER:SILVER);
 else if(ndefState==9){detailWrapped("Replace existing NFC URL?",AMBER);detailWrapped("Current: "+ndefExistingUrl,SILVER);detailWrapped("New: "+ndefUrl,SILVER);}
 else if(ndefState==10)detailWrapped("Checking authorization...",SKY);
 else if(ndefState==2){detailWrapped(ndefExistingUrl.length()?"Overwrite existing URL?":"Write new NFC URL?",AMBER);if(ndefExistingUrl.length())detailWrapped("Current: "+ndefExistingUrl,SILVER);detailWrapped("New: "+ndefUrl,SILVER);}
 else if(ndefState==3)detailWrapped(ndefAutoFlow?"Keep tag in place":"Checking server authorization",SILVER);
 else if(ndefState==4)detailWrapped(ndefAutoFlow?"Keep / return same tag":"Present tag again to write",AMBER);
 else if(ndefState==5)detailWrapped(ndefAutoFlow?"Keep tag in place - verifying":"Reporting read-back verification",SILVER);
 else if(ndefState==6){detailWrapped(ndefAutoFlow?"MakerTag ready":"Write verified by MakerVault",GREEN);if(ndefAutoFlow)detailWrapped("You may remove tag",SILVER);}
 else if(ndefState==7){if(ndefAutoFlow)detailWrapped("Assigned; NFC incomplete",AMBER);detailWrapped(ndefError,AMBER);}
 else if(ndefState==8)detailWrapped(ndefAutoFlow?"Keep / return same tag":"Present tag to verify",SILVER);
 if(ndefState!=9)detailScroll=0;
 detailPaint("NTAG215 write");
}
#endif
// Remote MakerTag target browser and minimal single-letter A-Z jump.
// Terminal-initiated sessions hand off to the existing verified NFC writer.
void rbCategoriesScreen(){
 display->fillScreen(BG);header("Add MakerTag");
 int top=rbCategory>2?rbCategory-2:0;
 if(top>4)top=4;
 for(int n=0;n<3;n++){
  int idx=top+n;if(idx>=7)break;
  int y=34+25*n;
  display->fillRoundRect(5,y,118,23,4,idx==rbCategory?NAVY:CARD);
  if(idx==rbCategory)display->fillRoundRect(5,y+3,3,17,1,SKY);
  String name=RB_NAMES[idx];if(name.length()>19)name=name.substring(0,18)+"~";
  textAt(12,y+8,name.c_str(),idx==rbCategory?WHITE:SILVER);
 }
 bottom("OK: open Back: exit");
}
// The selected row scrolls one character at a time, pausing at both ends.
// Unselected rows remain stationary. Keep the ID line and navigation fixed.
uint32_t rbMarqueeStart=0;
uint8_t rbMarqueeRow=255;
String rbVisibleTitle(const String& label,bool selected,uint8_t row){
 constexpr int WIDTH_CHARS=18; // 108px within the 120px row
 if(label.length()<=WIDTH_CHARS)return label;
 if(!selected)return label.substring(0,WIDTH_CHARS-1)+"~";
 if(rbMarqueeRow!=row){rbMarqueeRow=row;rbMarqueeStart=millis();}
 const uint32_t elapsed=millis()-rbMarqueeStart;
 const int steps=(int)label.length()-WIDTH_CHARS;
 // 900ms at the start, 190ms per character, 950ms at the end.
 const uint32_t moving=(uint32_t)steps*190;
 const uint32_t period=900+moving+950;
 const uint32_t phase=elapsed%period;
 const int offset=phase<900?0:phase<900+moving?
   min(steps,int((phase-900)/190)+1):steps;
 return label.substring(offset,offset+WIDTH_CHARS);
}
// Split a long title into up to three centred display lines. Prefer word
// boundaries, breaking an exceptionally long word only when necessary.
uint8_t rbWrapTitle(const String& title,String lines[3]){
 constexpr int LIMIT=19; // 114px in default 6px font
 String rest=title;
 rest.trim();
 uint8_t count=0;
 while(rest.length() && count<3){
  if(rest.length()<=LIMIT){lines[count++]=rest;break;}
  int cut=LIMIT;
  while(cut>0 && rest[cut]!=' ')--cut;
  if(cut<7)cut=LIMIT;
  lines[count++]=rest.substring(0,cut);
  rest=rest.substring(cut);
  rest.trim();
 }
 if(rest.length() && count==3 && lines[2].length()>3)
  lines[2]=lines[2].substring(0,LIMIT-1)+"~";
 return count;
}
void rbListScreen(){
 display->fillScreen(BG);header(RB_NAMES[rbCategory]);
 if(rbStatus==1||rbStatus==2){centeredAt(62,"Loading...",SILVER);bottom("Back: categories");return;}
 if(rbStatus==4){centeredAt(56,rbError.c_str(),AMBER);bottom("Back: categories");return;}
 if(!rbCount){centeredAt(56,"No records found",SILVER);bottom("Hold dial: A-Z");return;}
 int top=rbRow>2?rbRow-2:0;
 if(top>int(rbCount)-3)top=max(0,int(rbCount)-3);
 for(int n=0;n<3;n++){
  int idx=top+n;if(idx>=rbCount)break;
  int y=33+n*25;
  const bool selected=idx==rbRow;
  display->fillRoundRect(4,y,120,24,4,selected?NAVY:CARD);
  String label=rbVisibleTitle(rbRows[idx].label,selected,rbRow);
  textAt(11,y+3,label.c_str(),selected?WHITE:SILVER);
  String code=rbRows[idx].code;
  if(code.isEmpty())code="Ref: "+rbRows[idx].id.substring(0,8);
  if(code.length()>18)code=code.substring(0,17)+"~";
  textAt(11,y+14,code.c_str(),MUTED);
 }
 bottom("Hold dial: A-Z");
}
// Update only the selected row title while it scrolls. Redrawing the whole
// framebuffer every 190ms visibly flickers the header, ID rows and footer.
void rbMarqueePaint(){
 if(rbStatus!=3 || !rbCount || rbRow>=rbCount)return;
 const String& title=rbRows[rbRow].label;
 if(title.length()<=18)return;
 int top=rbRow>2?rbRow-2:0;
 if(top>int(rbCount)-3)top=max(0,int(rbCount)-3);
 const int y=33+(int(rbRow)-top)*25;
 display->fillRect(11,y+3,108,9,NAVY);
 const String visible=rbVisibleTitle(title,true,rbRow);
 textAt(11,y+3,visible.c_str(),WHITE);
}
void rbLetterScreen(){
 display->fillScreen(BG);
 centeredAt(14,"JUMP TO LETTER",SKY);
 char character[2]={RB_LETTERS[rbLetterIndex],0};
 // Use a proportional, smooth-outline GFX glyph instead of scaling the
 // original 5x7 bitmap. Fit its measured bounds into the letter area.
 display->setTextWrap(false);
 display->setFont(&FreeSansBold18pt7b);
 display->setTextColor(WHITE);
 display->setTextSize(2);
 int16_t x0,y0;uint16_t w,h;
 display->getTextBounds(character,0,0,&x0,&y0,&w,&h);
 if(w>110 || h>55){
  display->setTextSize(1);
  display->getTextBounds(character,0,0,&x0,&y0,&w,&h);
 }
 // GFX custom fonts use a baseline; centre the actual ink, not the cursor.
 const int16_t x=(128-(int)w)/2-x0;
 const int16_t y=30+(55-(int)h)/2-y0;
 display->setCursor(x,y);
 display->print(character);
 display->setFont(NULL);
 display->setTextSize(1);
 centeredAt(90,"Rotate to select",SILVER);
 centeredAt(102,"Confirm to jump",SILVER);
 bottom("Back: cancel");
}
void rbPreviewScreen(){
 display->fillScreen(BG);header("Selected record");
 String lines[3];const uint8_t count=rbWrapTitle(rbChosenName,lines);
 const int start=count==1?49:count==2?42:35;
 for(uint8_t i=0;i<count;i++)centeredAt(start+i*12,lines[i].c_str(),WHITE);
 String code=rbChosenCode;
 if(code.isEmpty())code="Ref: "+rbChosenId.substring(0,8);
 if(code.length()>19)code=code.substring(0,18)+"~";
 centeredAt(76,code.c_str(),SKY);
 if(rbBeginCancel)centeredAt(98,"Cancelling...",AMBER);
 else if(rbBeginStatus==1||rbBeginStatus==2)centeredAt(98,"Connecting...",SKY);
 else if(rbBeginStatus==4)centeredAt(98,rbBeginError.c_str(),AMBER);
 else centeredAt(98,"Assign to this?",SKY);
 bottom(rbBeginStatus==2?"Back: cancel":"OK: start Back: list");
}

// Four-row MakerTags menu; avoids truncating actions at the bottom.
bool makerTagCanCreate(){return mvPairVerified && mvCanWriteTags && mvCanSearchInventory;}
bool makerTagCanManage(){return mvPairVerified && mvCanWriteTags;}
const char *makerTagChoice(int index){
 if(index==0)return "Scan MakerTag";
 if(makerTagCanCreate() && index==1)return "Create MakerTag";
 int offset=1+int(makerTagCanCreate());
 if(makerTagCanManage() && index==offset)return "Clean MakerTag";
 if(makerTagCanManage() && index==offset+1)return "Remove MakerTag";
 return "";
}
void makerTagRow(int index){
 int y=30+index*20;
 display->fillRect(4,y,120,19,BG);
 display->fillRoundRect(5,y,118,18,3,index==subSelected?NAVY:CARD);
 if(index==subSelected)display->fillRoundRect(5,y+3,3,12,1,SKY);
 textAt(12,y+6,makerTagChoice(index),index==subSelected?WHITE:SILVER);
}
void makerTagsMenuScreen(){
 display->fillScreen(BG);header("MakerTags");
 for(int i=0;i<categoryCount();++i)makerTagRow(i);
 bottom("OK: open Back: home");
}
// Bound operation messages to the 128px display. The standard 6px font
// fits at most 19 characters in the 116px safe content width. Prefer
// word boundaries and use an ellipsis only when two rows cannot hold text.
String opFitLine(const String &value, int maxPixels=116){
 String result=value;
 int16_t x,y;uint16_t width,height;
 display->getTextBounds(result.c_str(),0,0,&x,&y,&width,&height);
 if(width<=maxPixels)return result;
 while(result.length() && width>maxPixels-12){
   result.remove(result.length()-1);
   display->getTextBounds(result.c_str(),0,0,&x,&y,&width,&height);
 }
 if(result.length()!=value.length())result+="..";
 return result;
}
void opCenteredText(const String &value,int y,uint16_t color){
 const String fit=opFitLine(value);
 centeredAt(y,fit.c_str(),color);
}
void opTwoLine(const String &value,int y,uint16_t color){
 int16_t x,yy;uint16_t width,height;
 display->getTextBounds(value.c_str(),0,0,&x,&yy,&width,&height);
 if(width<=116){centeredAt(y,value.c_str(),color);return;}
 int split=-1;
 // Find the last whole-word break that fits the first row.
 for(int i=0;i<(int)value.length();++i){
   if(value[i]!=' ')continue;
   const String first=value.substring(0,i);
   display->getTextBounds(first.c_str(),0,0,&x,&yy,&width,&height);
   if(width<=116)split=i;
 }
 if(split<0){
   // Long unbroken identifiers can still wrap without clipping.
   for(int i=1;i<(int)value.length();++i){
     const String first=value.substring(0,i);
     display->getTextBounds(first.c_str(),0,0,&x,&yy,&width,&height);
     if(width<=116)split=i;
   }
 }
 if(split<=0){opCenteredText(value,y,color);return;}
 opCenteredText(value.substring(0,split),y,color);
 String tail=value.substring(split);
 tail.trim();
 if(tail.length())opCenteredText(tail,y+13,color);
}
void makerTagOperationScreen(){
 display->fillScreen(BG);
 header(opAction=="clean"?"Clean MakerTag":"Remove MakerTag");
 if(opState==11){
  centeredAt(39,"Clean NFC too?",WHITE);
  centeredAt(64,opAlsoClean?"> Yes - clean NFC":"  Yes - clean NFC",opAlsoClean?SKY:SILVER);
  centeredAt(84,!opAlsoClean?"> No - keep NFC":"  No - keep NFC",!opAlsoClean?SKY:SILVER);
  bottom("OK: select  Back: no");
 }else if(opState==1){
  centeredAt(41,"Present MakerTag",SKY);
  if(opUid.length())opCenteredText(opUid,62,WHITE);
  if(opError.length())opTwoLine(opError,82,AMBER);
  bottom("Back: cancel");
 }else if(opState==2){
  opCenteredText(opMakerId,33,SKY);
  opTwoLine(opLabel,47,WHITE);
  centeredAt(79,opAlsoClean?"Clean NFC data?":"Remove MakerTag?",AMBER);
  if(opAction=="remove" && opAlsoClean)centeredAt(96,"Then unlink in app",SILVER);
  bottom("OK: yes  Back: no");
 }else if(opState==9){
  centeredAt(49,opAction=="clean"?"NFC data cleared":"MakerTag removed",GREEN);
  centeredAt(74,opAction=="clean"?"Record kept":"Inventory kept",SILVER);
  bottom("OK: finish");
 }else if(opState==10 || opState==12 || opState==13){
  centeredAt(35,opState==10?"Operation failed":"Partly complete",AMBER);
  opTwoLine(opError,55,WHITE);
  if(opState==12 || opState==13)centeredAt(88,"NFC data cleared",GREEN);
  bottom(opState==12||opState==13?"OK: retry":"OK: finish");
 }else{
  const char *progress=opState==3?"Finding MakerTag":
    opState==4?"Checking access":
    opState==5||opState==17?"Present same tag":
    opState==6?"Rescan same tag":
    opState==7||opState==14?"Reporting clean":
    opState==8||opState==15?"Removing record":"Working...";
  opCenteredText(progress,48,SKY);
  opCenteredText(opMakerId,75,SILVER);
  bottom(opState==5||opState==6?"Keep same tag":"Please wait");
 }
}
void makerTagOperationChoose(){
 if(opState==11){opState=1;opError="";}
 else if(opState==2){opConfirm();}
 else if(opState==12 || opState==13){opRetry();}
 else if(opState==9 || opState==10){opReset();page=MAKERTAGS_MENU;}
 render();
}

void render(){
 switch(page){
  case HOME:home();break;
  case SCAN:scanPage();break;
  case REGISTRATION:registrationScreen();break;
  case LOOKUP_REQUEST:remoteLookupScreen();break;
#if MAKERVAULT_NDEF_WRITER_ENABLED
  case NDEF_WRITE:ndefWriterScreen();break;
  case TAG_OPERATION:makerTagOperationScreen();break;
#endif
  case RB_CATEGORIES:rbCategoriesScreen();break;
  case RB_LIST:rbListScreen();break;
  case RB_LETTER:rbLetterScreen();break;
  case RB_PREVIEW:rbPreviewScreen();break;
  case RECENT: simple("Recent tag","Not available");break;
  case CONTROLS:simple("Control test","Turn / press", "Back exits");break;
  case CONNECTIONS:connections();break;
  case WIFI_MENU:wifiMenu();break;
  case MV_MENU:makerMenu();break;
  case MV_FORGET:forgetPairScreen();break;
  case MV_CA_REMOVE:removeCaScreen();break;
  case KNOWN_WIFI:knownNetworks();break;
  case DELETE_WIFI:deleteNetworkScreen();break;
  case MAKERVAULT_SETUP:mvSettings();break;
  case MV_STATUS:mvStatusPage();break;
  case MV_RECONNECT:mvReconnectPage();break;
  case MV_TLS_TEST:mvTlsTestPage();break;
  case MV_PAIR:mvPairPage();break;
  case SETUP_WIFI:drawSetupQR(*display,BG,WHITE);break;
  case INFO:info();break;
  case WIFI_STATUS:wifiStatusPage();break;
  case MAKERTAGS_MENU:makerTagsMenuScreen();break;
  case RFID_MENU:categoryPage("RFID Tags","Read RFID tag",categoryCount()>1?"Write RFID tag":"");break;
  case UNAVAILABLE:simple(unavailableTitle.c_str(),"Coming later","No tag written");break;
 }
}
void control(const char* event){
 Serial.print("[CONTROL] ");Serial.println(event);
 if(page==CONTROLS){display->fillRoundRect(10,102,108,10,2,NAVY);textAt(14,103,event,WHITE);feedbackUntil=millis()+850;}
}
int categoryCount(){
 if(page==MAKERTAGS_MENU)return 1+int(makerTagCanCreate())+2*int(makerTagCanManage());
 if(page==RFID_MENU)return 1+int(RFID_WRITE_IMPLEMENTED && mvCanWriteTags && mvPairVerified);
 return 1;
}
void move(int dir){
 if(page==RB_CATEGORIES){rbCategory=(rbCategory+7+dir)%7;rbCategoriesScreen();return;}
 if(page==RB_LETTER){rbLetterIndex=(rbLetterIndex+27+dir)%27;rbLetterScreen();return;}
 if(page==RB_LIST){
  if(rbStatus!=3||!rbCount)return;
  if(dir>0){
   if(rbRow+1<rbCount)rbRow++;
   else if(rbMore){rbQueue(rbOffset+rbCount,rbLetter);rbDispatch();}
  }else{
   if(rbRow>0)rbRow--;
   else if(rbOffset>0){rbQueue(max(0,rbOffset-RB_PAGE_SIZE),rbLetter,true);rbDispatch();}
  }
  rbListScreen();return;
 }

 if(page==NDEF_WRITE && ndefState==9){detailMove(dir,"NTAG215 write");return;}
 if(page==MV_STATUS){detailMove(dir,"MakerVault link");return;}
 if(page==MV_TLS_TEST){detailMove(dir,"Test HTTPS");return;}
 if(page==WIFI_STATUS){detailMove(dir,"Wi-Fi status");return;}
 if(page==INFO){detailMove(dir,"System info");return;}
 if(page==TAG_OPERATION && opState==11){opAlsoClean=!opAlsoClean;makerTagOperationScreen();return;}
 if(page==MAKERTAGS_MENU){int old=subSelected;subSelected=(subSelected+dir+categoryCount())%categoryCount();
  if(old!=subSelected){makerTagRow(old);makerTagRow(subSelected);}return;}
 if(page==RFID_MENU){int old=subSelected;subSelected=(subSelected+dir+categoryCount())%categoryCount();
  if(old!=subSelected){categoryRow(old,old==0?"Read RFID tag":"Write RFID tag");categoryRow(subSelected,subSelected==0?"Read RFID tag":"Write RFID tag");}return;}
 if(page==CONTROLS){control(dir>0?"Clockwise":"Anticlockwise");return;}
 if(page==CONNECTIONS){int old=connSelected;connSelected=(connSelected+dir+2)%2;connectionRow(old);connectionRow(connSelected);return;}
 if(page==WIFI_MENU){int old=wifiSelected;wifiSelected=(wifiSelected+dir+WIFI_MENU_COUNT)%WIFI_MENU_COUNT;wifiRow(old);wifiRow(wifiSelected);return;}
 if(page==MV_MENU){int old=mvSelected;mvSelected=(mvSelected+dir+7)%7;makerRow(old);makerRow(mvSelected);return;}
 if(page==KNOWN_WIFI){if(knownCount){int old=networkSelected;networkSelected=(networkSelected+dir+knownCount)%knownCount;knownNetworkRow(old);knownNetworkRow(networkSelected);}return;}
 if(page!=HOME)return;
 int old=selected;selected=(selected+dir+4)%4;
 menuItem(old);menuItem(selected);
 Serial.print("[MENU] ");Serial.println(choices[selected]);
}
void choose(){
 if(page==RB_CATEGORIES){rbQueue(0,"");page=RB_LIST;rbDispatch();render();return;}
 if(page==RB_LETTER){
  String letter=String(RB_LETTERS[rbLetterIndex]);
  rbQueue(0,letter);page=RB_LIST;rbDispatch();render();return;
 }
 if(page==RB_PREVIEW){rbBeginSelected();rbPreviewScreen();return;}
 if(page==RB_LIST){
  if(rbStatus==3 && rbCount){
   rbChosenId=rbRows[rbRow].id;rbChosenName=rbRows[rbRow].label;
   rbChosenCode=rbRows[rbRow].code;page=RB_PREVIEW;render();
  }
  return;
 }

 if(page==TAG_OPERATION){makerTagOperationChoose();return;}
 if(page==MAKERTAGS_MENU){
  const String action=makerTagChoice(subSelected);
  if(action=="Scan MakerTag"){scanMakerTagsMode=true;page=SCAN;scanResultVisible=false;scanLookupState=0;}
  else if(action=="Create MakerTag"){rbCategory=0;page=RB_CATEGORIES;}
  else if(action=="Clean MakerTag"){opStart("clean");page=TAG_OPERATION;}
  else if(action=="Remove MakerTag"){opStart("remove");page=TAG_OPERATION;}
  render();return;
 }
 if(page==RFID_MENU){
  if(subSelected==0){scanMakerTagsMode=false;page=SCAN;scanResultVisible=false;scanLookupState=0;render();}
  else if(subSelected<categoryCount()){
   if(page==MAKERTAGS_MENU && subSelected==1 &&
       mvPairVerified && mvCanWriteTags && mvCanSearchInventory){
    rbCategory=0;page=RB_CATEGORIES;render();return;
   }
   unavailableTitle="Operation unavailable";page=UNAVAILABLE;render();
  }
  return;
 }
 if(page==CONTROLS){control("Select");return;}
 if(page==CONNECTIONS){page=connSelected==0?WIFI_MENU:MV_MENU;render();return;}
 if(page==WIFI_MENU){
  if(wifiSelected==0){
   if(wifiManualOffline || WiFi.status()!=WL_CONNECTED)wifiSetManualOffline(false);
   else wifiSetManualOffline(true);
   render();
  }else if(wifiSelected==1){page=WIFI_STATUS;render();}
  else if(wifiSelected==2){networkSelected=0;page=KNOWN_WIFI;render();}
  else if(wifiSelected==3){wifiSetManualOffline(false);beginPortal();if(setupAPActive){page=SETUP_WIFI;render();}}
  else {wifiSetManualOffline(false);if(WiFi.status()!=WL_CONNECTED){lastReconnectTry=millis()-12001;}else mvRequestCheck();render();}
  return;
 }
 if(page==MV_MENU){
  if(mvSelected==0){detailScroll=0;page=MV_STATUS;render();}
  else if(mvSelected==1){
   // Avoid interrupting a physical NFC clean, registration or browser handoff.
   bool busyTag=(regState==1||regState==2||regState==4||regState==6||
                  remoteLookupState==1||remoteLookupState==2);
#if MAKERVAULT_NDEF_WRITER_ENABLED
   busyTag=busyTag||(ndefState==1||ndefState==2||ndefState==4||ndefState==8||
                     (opState!=0 && opState!=9 && opState!=10));
#endif
   if(!busyTag && (mvReconnectState==1 || mvReconnectState==2)){
    page=MV_RECONNECT;render();
   }else if(!busyTag && !wifiManualOffline && mvReconnectServer()){
    // Existing WiFiMulti fallback handles saved networks if needed.
    lastReconnectTry=millis()-12001UL;
    page=MV_RECONNECT;render();
   }else{
    simple("Reconnect server",busyTag?"Finish tag task":
           (wifiManualOffline?"Wi-Fi set offline":"Unable to reconnect"),
           busyTag?"Try again after":
           (wifiManualOffline?"Enable Wi-Fi first":"Check saved pairing"));
   }
  }
  else if(mvSelected==2){detailScroll=0;mvStartHttpsTest();page=MV_TLS_TEST;render();}
  else if(mvSelected==3){page=MV_PAIR;if(mvPairState!=2)mvStartPairing();render();}
  else if(mvSelected==4){beginMakerVaultPortal();if(setupPortalRunning()){page=MAKERVAULT_SETUP;render();}}
  else if(mvSelected==5){page=MV_CA_REMOVE;render();}
  else {page=MV_FORGET;render();}
  return;
 }
 if(page==KNOWN_WIFI){connectKnownNetwork();return;}
 if(page==MV_CA_REMOVE){
  if(mvRemoveCustomCA()){page=MV_MENU;render();}
  else {simple("CA removal", "Busy or save failed", "Back to menu");page=MV_MENU;}
  return;
 }
 if(page==MV_FORGET){if(mvForgetLocalPairing()){page=MV_MENU;render();}else {page=MV_MENU;render();}return;}
 if(page==MV_PAIR){if(mvPairState!=2)mvStartPairing();render();return;}
 if(page==MV_STATUS){mvRequestCheck();render();return;}
 if(page==MV_RECONNECT){
  if(mvReconnectState==4){if(mvReconnectServer())render();}
  else if(mvReconnectState==3 || mvReconnectState==0){page=MV_MENU;render();}
  return;
 }
 if(page!=HOME)return;
 page=(selected==0)?MAKERTAGS_MENU:(selected==1?RFID_MENU:(selected==2?CONNECTIONS:INFO));subSelected=0;
 Serial.print("[MENU] Selected: ");Serial.println(choices[selected]);render();
}
void back(){
 if(page==MV_RECONNECT){page=MV_MENU;render();return;}
 if(page==RB_LETTER){page=RB_LIST;render();return;}
 if(page==RB_PREVIEW){
  if(rbBeginStatus==1){rbBeginStatus=0;rbBeginCancel=false;}
  else if(rbBeginStatus==2){rbBeginCancel=true;rbBeginError="Cancelling...";rbPreviewScreen();return;}
  rbBeginStatus=0;page=RB_LIST;render();return;
 }
 if(page==RB_LIST){rbEpoch++;rbStatus=0;page=RB_CATEGORIES;render();return;}
 if(page==RB_CATEGORIES){page=MAKERTAGS_MENU;subSelected=0;render();return;}
 if(page==TAG_OPERATION){
  if(opState==5||opState==6||opState==7||opState==12||opState==13||opState==14||opState==15){
   opError="Clean may be incomplete";makerTagOperationScreen();return;
  }
  if(mvTask && (opState==3||opState==4)){opError="Finishing server check";makerTagOperationScreen();return;}
  opCancel();page=MAKERTAGS_MENU;render();return;
 }

#if MAKERVAULT_NDEF_WRITER_ENABLED
 if(page==NDEF_WRITE){ndefReset(ndefState!=6);page=MAKERTAGS_MENU;render();return;}
#endif
 if(page==LOOKUP_REQUEST && remoteLookupState!=2){remoteLookupReset();page=MAKERTAGS_MENU;render();return;}
 if(page==REGISTRATION && regState==3){Serial.println("[REGISTRATION] Request still submitting; Back cannot interrupt network task");registrationScreen();return;}
 if(page==REGISTRATION && regState!=3){regCancel();page=MAKERTAGS_MENU;render();return;}
 Serial.println("[BUTTON] BACK");if(page==DELETE_WIFI){pendingDeleteSSID="";page=KNOWN_WIFI;render();return;}if(page==SETUP_WIFI || page==MAKERVAULT_SETUP){if(lanPortalActive)stopPortal();page=(page==SETUP_WIFI)?WIFI_MENU:MV_MENU;render();return;}if(page==KNOWN_WIFI||page==WIFI_STATUS){page=WIFI_MENU;render();return;}
 if(page==MV_PAIR){if(mvPairState==1||mvPairState==2)mvCancelPairing();page=MV_MENU;render();return;}
 if(page==SCAN){page=selected==0?MAKERTAGS_MENU:RFID_MENU;render();return;}
 if(page==UNAVAILABLE){page=selected==0?MAKERTAGS_MENU:RFID_MENU;render();return;}
 if(page==MV_STATUS||page==MV_TLS_TEST||page==MV_PAIR||page==MV_FORGET||page==MV_CA_REMOVE){page=MV_MENU;render();return;}
 if(page==WIFI_MENU||page==MV_MENU){page=CONNECTIONS;render();return;}if(page!=HOME){page=HOME;render();}
}
void processInputs(){
 static uint32_t rbPressAt=0;
 static bool rbHoldUsed=false;

 // Only meaningful menu input defers reader setup.
 const int oldSelection=selected; const Page oldPage=page;
 uint8_t ab=(digitalRead(ENC_A)<<1)|digitalRead(ENC_B);
 if(ab!=previousAB){lastEncoderTurnAt=millis();stepCount+=decode[(previousAB<<2)|ab];previousAB=ab;
  if(stepCount>=2||stepCount<=-2){int dir=stepCount>0?1:-1;stepCount=0;move(dir);}}
 const bool selectPressed=selectKey.pressed();
 // KY-040 push-switch contact can briefly chatter while its shaft rotates.
 // Consume the debounced event, but never turn rotation into a select action.
 if(selectPressed && (uint32_t)(millis()-lastEncoderTurnAt)>=180){
  Serial.println("[BUTTON] SELECT");
  if(page==KNOWN_WIFI && knownCount && networkSelected<knownCount){
   pendingDeleteSSID=knownSSID[networkSelected];page=DELETE_WIFI;render();
  }else if(page==RB_LIST){rbPressAt=millis();rbHoldUsed=false;}
  else if(page!=DELETE_WIFI)choose();
 }
 // A short knob click selects a record; holding it opens the minimal
 // large-letter A-Z jump. Do not fire the short-click action first.
 if(rbPressAt && page==RB_LIST && !selectKey.stable &&
    !rbHoldUsed && (uint32_t)(millis()-rbPressAt)>=650){
  rbHoldUsed=true;
  char current=rbLetter.length()?rbLetter[0]:(rbCount?rbRows[rbRow].label[0]:'A');
  current=toupper((unsigned char)current);
  rbLetterIndex=(current>='A'&&current<='Z')?current-'A'+1:0;
  page=RB_LETTER;render();
 }
 if(rbPressAt && selectKey.stable){
  if(!rbHoldUsed && page==RB_LIST)choose();
  rbPressAt=0;
 }
 if(backKey.pressed())back();
 if(confirmKey.pressed()){
  Serial.println("[BUTTON] CONFIRM");
#if MAKERVAULT_NDEF_WRITER_ENABLED
  if(page==NDEF_WRITE){
   if(ndefState==9){
    // One physical Confirm approves this overwrite. If an HTTPS task is
    // already running, queue authorization rather than show another prompt.
    ndefForeignUrlOverride=true;ndefState=10;
   }
   else if(ndefState==2)ndefConfirm();
   else if(ndefState==6||ndefState==7){ndefReset(false);page=MAKERTAGS_MENU;}
   render();return;
  }
#endif
  if(page==TAG_OPERATION){makerTagOperationChoose();return;}
  if(page==REGISTRATION && (regState==2||regState==6)){regSubmit(regUid,regKind);registrationScreen();return;}
  if(page==REGISTRATION && regState==4){regReset();page=MAKERTAGS_MENU;render();return;}
  if(page==RB_CATEGORIES||page==RB_LIST||page==RB_LETTER||page==RB_PREVIEW)choose();
  else if(page==HOME)choose();else if(page==CONTROLS)control("Confirm");
  else if(page==SCAN){scanResultVisible=false;scanLookupQueued=false;scanLookupState=0;cfsDetected=false;cfsLookupQueued=false;cfsLookupState=0;cfsMaterialLookupState=0;scanPage();}
  else if(page==DELETE_WIFI){
   // Resolve by SSID, not list index, to avoid deleting the wrong network.
   for(uint8_t i=0;i<knownCount;i++){
    if(knownSSID[i]==pendingDeleteSSID){forgetNetwork(i);break;}
   }
   pendingDeleteSSID="";
   if(networkSelected>=knownCount && networkSelected>0)networkSelected--;
   page=KNOWN_WIFI;render();
  }
  else if(page==CONNECTIONS||page==WIFI_MENU||page==MV_MENU||page==MV_FORGET||page==MV_CA_REMOVE||page==KNOWN_WIFI||page==MV_PAIR||page==MV_STATUS||page==MV_TLS_TEST||page==MAKERTAGS_MENU||page==RFID_MENU){choose();}
 }
 if(feedbackUntil&&(int32_t)(millis()-feedbackUntil)>=0){feedbackUntil=0;if(page==CONTROLS)render();}
 if(oldSelection!=selected || oldPage!=page || !digitalRead(ENC_SW) || !digitalRead(BACK_PIN) || !digitalRead(CONFIRM_PIN))lastInputAt=millis();
}
void readerInit(){
 Serial.println("[RFID] Initialising reader");
 digitalWrite(TFT_CS,HIGH);digitalWrite(RFID_CS,HIGH);
 rfid.PCD_Init();
 versionReg=rfid.PCD_ReadRegister(MFRC522::VersionReg);
 Serial.printf("[RFID] Version = 0x%02X\n",versionReg);
 knownReader=(versionReg==0x88||versionReg==0x90||versionReg==0x91||versionReg==0x92);
 if(!knownReader){
   byte check=rfid.PCD_ReadRegister(MFRC522::VersionReg);
   Serial.printf("[RFID] Verification = 0x%02X\n",check);
   if(check==versionReg)Serial.println("[RFID] Unrecognised but stable version");
 }
 // Hardware communications check. Reversibly change a reader timer register,
 // read it back, then restore. This never writes to a card/tag.
 // Useful for compatible RC522 clones with nonstandard VersionReg values.
 const byte saved=rfid.PCD_ReadRegister(MFRC522::TReloadRegL);
 const byte probe=(saved==0x5A)?0xA5:0x5A;
 rfid.PCD_WriteRegister(MFRC522::TReloadRegL,probe);
 const byte seen=rfid.PCD_ReadRegister(MFRC522::TReloadRegL);
 rfid.PCD_WriteRegister(MFRC522::TReloadRegL,saved);
 const byte restored=rfid.PCD_ReadRegister(MFRC522::TReloadRegL);
 readerBusVerified=(seen==probe && restored==saved &&
                    versionReg!=0x00 && versionReg!=0xFF);
 Serial.printf("[RFID] SPI register probe: %s (0x%02X => 0x%02X => 0x%02X)\n",
               readerBusVerified?"PASS":"FAIL",saved,seen,restored);
 readerInitDone=true;
 Serial.printf("[SYSTEM] Reader check complete at %lu ms\n",millis()-bootAt);
 // Update just the RFID status dot, not the entire home screen.
 // A full redraw here previously made input seem unresponsive.
 if(page==HOME){
  display->fillRect(4,117,9,9,BG);
  display->fillCircle(8,121,3,readerReady()?GREEN:AMBER);
 }
}

void pollTag(){
#if MAKERVAULT_NDEF_WRITER_ENABLED
 const bool ndefScanning=(page==NDEF_WRITE && (ndefState==1 || ndefState==4 || ndefState==8));
 const bool opScanning=(page==TAG_OPERATION && (opState==1 || opState==5 || opState==6 || opState==17));
 if(!ndefScanning && ndefState!=0 && page==NDEF_WRITE)return;
#else
 const bool ndefScanning=false,opScanning=false;
#endif
 if((!ndefScanning && !opScanning && page!=SCAN && !(page==REGISTRATION && regState==1) && !(page==LOOKUP_REQUEST && remoteLookupState==1))||(page==SCAN && scanResultVisible)||(uint32_t)(millis()-lastPoll)<100)return;
 lastPoll=millis();digitalWrite(TFT_CS,HIGH);
 bool cardReady=false;
#if MAKERVAULT_NDEF_WRITER_ENABLED
 if((ndefScanning && ndefAutoFlow) || (opScanning && (opState==5 || opState==6 || opState==17))){
   // A tag already scanned during registration may be in HALT, not IDLE.
   // REQA (IsNewCardPresent) only sees IDLE tags. WUPA is required to
   // reselect the SAME still-present tag without a second physical tap.
   byte atqa[2]={};byte atqaSize=sizeof(atqa);
   cardReady=(rfid.PICC_WakeupA(atqa,&atqaSize)==MFRC522::STATUS_OK);
 } else
#endif
 cardReady=rfid.PICC_IsNewCardPresent();
 if(!cardReady || !rfid.PICC_ReadCardSerial())return;
 String uid="";
 for(byte i=0;i<rfid.uid.size;i++){
  if(rfid.uid.uidByte[i]<16)uid+='0';uid+=String(rfid.uid.uidByte[i],HEX);
 }
 uid.toUpperCase();recentUid=uid;
 recentType=String(rfid.PICC_GetTypeName(rfid.PICC_GetType(rfid.uid.sak)));
#if MAKERVAULT_NDEF_WRITER_ENABLED
 if(opScanning){
  opScan(rfid,uid);
  rfid.PICC_HaltA();rfid.PCD_StopCrypto1();
  makerTagOperationScreen();return;
 }
 if(ndefScanning){
  if(ndefState==8){
   MakerVaultRc522PageIO io(rfid);
   uint8_t fresh[MakerVaultNtag215::kUserBytes]={};
   if(!MakerVaultNtag215::readNdefArea(io,fresh) ||
      !MakerVaultNtag215::verifyReadback(rfid.uid.uidByte,rfid.uid.size,ndefUid.c_str(),ndefUrl.c_str(),fresh,sizeof(fresh))){
     ndefError="Fresh read-back failed";ndefState=7;
   }else ndefState=5;
  }else if(ndefState==1){
   MakerVaultRc522PageIO io(rfid);
   MakerVaultNtag215::MemoryInfo info={false,false,0};
   uint8_t area[MakerVaultNtag215::kUserBytes]={};
   if(rfid.uid.size!=7 || !MakerVaultNtag215::matchesUid(
        rfid.uid.uidByte,rfid.uid.size,ndefUid.c_str())){
    // No page access or write has occurred. Keep the expected UID bound to
    // this request and let the operator return the original physical tag.
    ndefError="Wrong tag - return original";
    Serial.println("[NDEF] Wrong UID during read-only inspection; awaiting original tag");
   }else if(!MakerVaultNtag215::inspectMemory(io,rfid.uid.uidByte,info)){
    ndefError="Return same tag to read";
   }else if(!info.supported){
    ndefError="Not NTAG215 (CC)";ndefState=7;
   }else if(!info.writable){
    ndefError="Locked / protected tag";ndefState=7;
   }else if(!MakerVaultNtag215::readNdefArea(io,area)){
    ndefError="Return same tag to read";
   }else{
    // Pre-write inspection is read-only. A transient RF loss can be retried
    // after reselecting the same physical UID; no NFC pages were changed.
    ndefError="";
    const auto decision=MakerVaultNtag215::assess(
      info,rfid.uid.uidByte,rfid.uid.size,ndefUid.c_str(),
      ndefTagId.c_str(),ndefUrl.c_str(),area,sizeof(area),true,true);
    if(decision==MakerVaultNtag215::WRITE_READY){
      char existingUrl[MakerVaultNdef::kMaxUriLength+1]={};
      ndefExistingUrl=MakerVaultNdef::decodeUri(area,sizeof(area),existingUrl,sizeof(existingUrl))
        ? String(existingUrl) : String("");
      if(ndefAutoFlow && ndefExistingUrl==ndefUrl &&
         MakerVaultNtag215::verifyReadback(rfid.uid.uidByte,rfid.uid.size,
                                            ndefUid.c_str(),ndefUrl.c_str(),area,sizeof(area))){
        // Already programmed with this permanent URL: no unnecessary write.
        ndefState=5;
      } else if(ndefAutoFlow) {
        // One physical Confirm covered assignment and NFC programming.
        // The server still reauthorizes the exact UID + URL before a write.
        ndefState=2;
        ndefConfirm();
      } else ndefState=2;
    }
    else if(decision==MakerVaultNtag215::WRITE_REJECT_FOREIGN_CONTENT){
      char existingUrl[MakerVaultNdef::kMaxUriLength+1]={};
      if(MakerVaultNdef::decodeUri(area,sizeof(area),existingUrl,sizeof(existingUrl))){
       ndefExistingUrl=String(existingUrl);
       ndefForeignUrlOverride=false;
       // Do not overwrite until a second, explicit physical Confirm.
       ndefState=9;
      }else{
       ndefError="Unrecognised NFC data; protected";
       ndefState=7;
      }
    }
    else{
      ndefError=decision==MakerVaultNtag215::WRITE_REJECT_FOREIGN_CONTENT
        ?"Existing NDEF needs override"
        :decision==MakerVaultNtag215::WRITE_REJECT_URL
        ?"Invalid MakerVault URL"
        :decision==MakerVaultNtag215::WRITE_REJECT_UID
        ?"Wrong tag UID":"Tag safety check failed";
      ndefState=7;
    }
   }
   if(ndefState==7)Serial.printf("[NDEF] Pre-write inspection: %s\\n",ndefError.c_str());
  }else if(ndefState==4){
   MakerVaultRc522PageIO io(rfid);
   if(!mvPairVerified || !mvCanWriteTags ||
      (uint32_t)(millis()-ndefAuthorizedAt)>15000UL){ndefError="UID or authorization expired";ndefState=7;}
   else if(rfid.uid.size!=7 || !MakerVaultNtag215::matchesUid(
        rfid.uid.uidByte,rfid.uid.size,ndefUid.c_str())){
    // Do not attempt *any* page write to a substituted tag. The original
    // UID can return within the existing short authorization window.
    ndefError="Wrong tag - return original";
    Serial.println("[NDEF] Wrong UID before write; awaiting original tag");
   }else {
    ndefError="";
    const auto result=MakerVaultNtag215::writeNdef(io,rfid.uid.uidByte,ndefUid.c_str(),ndefTagId.c_str(),ndefUrl.c_str(),true,true,ndefForeignUrlOverride);
    if(result!=MakerVaultNtag215::RESULT_VERIFIED){
     // Distinguish a refused write from a partially changed tag. Never
     // automatically retry physical writes after an uncertain result.
     switch(result){
      case MakerVaultNtag215::RESULT_READ_FAILED: ndefError="Cannot read tag";break;
      case MakerVaultNtag215::RESULT_UNSAFE: ndefError="Tag safety check refused";break;
      case MakerVaultNtag215::RESULT_INVALID_URL: ndefError="Invalid NFC URL";break;
      case MakerVaultNtag215::RESULT_WRITE_FAILED: ndefError="NFC page write failed";break;
      case MakerVaultNtag215::RESULT_READBACK_MISMATCH: ndefError="NFC read-back mismatch";break;
      default: ndefError="Write not verified";break;
     }
     Serial.printf("[NDEF] Transaction failed, result=%d; no success recorded\\n",(int)result);
     ndefState=7;
    }
    else ndefState=8;
   }
  }
  rfid.PICC_HaltA();rfid.PCD_StopCrypto1();render();
  if(ndefState==5)ndefSubmitVerified();
  return;
 }
#endif
 // Only the generic Read RFID screen inspects a possible Creality CFS
 // material sector. MakerTag creation, registration and NTAG215 writing
 // keep their existing behaviour and never read these CFS sectors.
 cfsDetected=false;
 elegooDetected=false;
 bambuDetected=false;
 if(page==SCAN && !scanMakerTagsMode &&
    rfid.PICC_GetType(rfid.uid.sak)==MFRC522::PICC_TYPE_MIFARE_UL){
  ElegooTag::Material sample={};
  if(ElegooTag::readDocumentedTag(rfid,sample)){
   elegooMaterial=sample;
   elegooDetected=true;
  }
 }
 if(page==SCAN && !scanMakerTagsMode &&
    rfid.PICC_GetType(rfid.uid.sak)==MFRC522::PICC_TYPE_MIFARE_1K){
  CfsTag::Material decoded={};
  if(CfsTag::readMaterialSector(rfid,decoded)){
   cfsMaterial=decoded;
   cfsDetected=true;
  }
 }
 if(page==SCAN && !scanMakerTagsMode && !cfsDetected &&
    rfid.PICC_GetType(rfid.uid.sak)==MFRC522::PICC_TYPE_MIFARE_1K){
  rfid.PCD_StopCrypto1();
  byte atqa[2]={};byte atqaLen=sizeof(atqa);
  if(rfid.PICC_WakeupA(atqa,&atqaLen)==MFRC522::STATUS_OK &&
     rfid.PICC_ReadCardSerial()){
    String fresh="";
    for(byte j=0;j<rfid.uid.size;j++){
      if(rfid.uid.uidByte[j]<16)fresh+='0';
      fresh+=String(rfid.uid.uidByte[j],HEX);
    }
    fresh.toUpperCase();
    if(fresh==uid){
      BambuTag::Material sample={};
      if(BambuTag::readDocumentedTag(rfid,sample)){
        bambuMaterial=sample;bambuDetected=true;
      }
    }
  }
 }
 rfid.PICC_HaltA();rfid.PCD_StopCrypto1();
 if(page==LOOKUP_REQUEST){
  auto family=rfid.PICC_GetType(rfid.uid.sak);
  remoteLookupSubmit(uid,family==MFRC522::PICC_TYPE_MIFARE_UL?"nfc":"rfid");
  remoteLookupScreen();return;
 }
 if(page==REGISTRATION){
  // RC522 card-family detection cannot distinguish NTAG215 from all
  // other Type 2 / Ultralight-compatible tags. Validate model separately
  // before enabling any tag-memory write capability.
  MFRC522::PICC_Type family=rfid.PICC_GetType(rfid.uid.sak);
  if(family!=MFRC522::PICC_TYPE_MIFARE_UL && family!=MFRC522::PICC_TYPE_MIFARE_1K){
   regError="Unsupported tag";regState=5;registrationScreen();return;
  }
  regUid=uid;
  regKind=(family==MFRC522::PICC_TYPE_MIFARE_UL?"nfc":"rfid");
  regState=7;registrationScreen();regScheduleProbe();return;
 }
 hasScanned=true;scanResultVisible=true;
 if(cfsDetected){
  scanLookupQueued=false;scanLookupState=0;
  cfsSpoolLookupBegin(recentUid, String(cfsMaterial.materialId));
 }else if(elegooDetected || bambuDetected){
  // No material or physical spool association from unverified third-party payloads.
  scanLookupQueued=false;scanLookupState=0;cfsLookupQueued=false;cfsLookupState=0;
 }else{
  cfsLookupQueued=false;cfsLookupState=0;
  scanLookupBegin(recentUid,rfid.PICC_GetType(rfid.uid.sak)==MFRC522::PICC_TYPE_MIFARE_UL?"nfc":"rfid");
 }
 Serial.printf("[RFID] UID=%s, Type=%s\n",recentUid.c_str(),recentType.c_str());
 scanPage();
}
// Emergency protection against the long-idle TLS heap exhaustion seen on
// physical ESP32-S3 terminals. This is a controlled reboot, not a heap
// allocator purge and not a substitute for fixing the TLS retention issue.
MakerVaultMemoryRecovery::Guard memoryRecoveryGuard;
uint32_t memoryRecoveryLastCheck = 0;
uint32_t memoryDiagnosticLastLog = 0;
void memoryDiagnosticLoop() {
  const uint32_t now = millis();
  if ((uint32_t)(now - memoryDiagnosticLastLog) < 30000UL || mvTask) return;
  memoryDiagnosticLastLog = now;
  // Measured outside mvHttps, after the task normally exits. The number of
  // active RTOS tasks helps distinguish delayed task cleanup from TLS retention.
  Serial.printf("[HEAP IDLE] uptime_ms=%lu https_done=%lu tasks=%u free=%u largest=%u min_free=%u\n",
    (unsigned long)now, (unsigned long)mvHttpsCompletedCount,
    (unsigned)uxTaskGetNumberOfTasks(),
    (unsigned)heap_caps_get_free_size(MALLOC_CAP_INTERNAL | MALLOC_CAP_8BIT),
    (unsigned)heap_caps_get_largest_free_block(MALLOC_CAP_INTERNAL | MALLOC_CAP_8BIT),
    (unsigned)heap_caps_get_minimum_free_size(MALLOC_CAP_INTERNAL | MALLOC_CAP_8BIT));
}


void memoryRecoveryLoop() {
  const uint32_t now = millis();
  if ((uint32_t)(now - memoryRecoveryLastCheck) <
      MakerVaultMemoryRecovery::kCheckIntervalMs) return;
  memoryRecoveryLastCheck = now;

  const size_t freeHeap = heap_caps_get_free_size(MALLOC_CAP_INTERNAL | MALLOC_CAP_8BIT);
  const size_t largestBlock = heap_caps_get_largest_free_block(MALLOC_CAP_INTERNAL | MALLOC_CAP_8BIT);

  // Do not reboot while a TLS worker, pairing/provisioning or physical tag
  // workflow is in progress. This protects writes, verified erasures and
  // server-side completion steps from an unexpected local reset.
  bool safeToRestart = !mvTask && !mvTestRunning &&
      mvPairState != 1 && mvPairState != 2 &&
      !setupAPActive && !lanPortalActive &&
      regState == 0 && remoteLookupState == 0;
#if MAKERVAULT_NDEF_WRITER_ENABLED
  safeToRestart = safeToRestart && ndefState == 0 && opState == 0;
#endif
  const bool previouslyLow = memoryRecoveryGuard.lowSeen;
  const bool restart = memoryRecoveryGuard.check(now, freeHeap, largestBlock, safeToRestart);
  if (memoryRecoveryGuard.lowSeen && !previouslyLow)
    Serial.printf("[MEMORY] Low heap detected: free=%u largest=%u; awaiting sustained low memory and safe idle\n",
                  (unsigned)freeHeap, (unsigned)largestBlock);
  else if (!memoryRecoveryGuard.lowSeen && previouslyLow)
    Serial.println("[MEMORY] Heap recovered; cancelled low-memory reboot");

  if (!restart) return;
  Serial.printf("[MEMORY] Recovery reboot: free=%u largest=%u uptime_ms=%lu; no active NFC or TLS work\n",
                (unsigned)freeHeap, (unsigned)largestBlock, (unsigned long)now);
  Serial.flush();
  delay(100);
  esp_restart(); // Restores TLS memory and reconnects using saved Wi-Fi / pairing settings.
}

void setup(){
 bootAt=millis();Serial.begin(115200);
  Serial.printf("[SYSTEM] Reset reason=%d (esp_reset_reason)\n", (int)esp_reset_reason());
 led.begin();led.setBrightness(0);led.clear();led.show();
 pinMode(TFT_CS,OUTPUT);digitalWrite(TFT_CS,HIGH);
 pinMode(RFID_CS,OUTPUT);digitalWrite(RFID_CS,HIGH);
 pinMode(ENC_A,INPUT_PULLUP);pinMode(ENC_B,INPUT_PULLUP);
 selectKey.begin(ENC_SW);backKey.begin(BACK_PIN);confirmKey.begin(CONFIRM_PIN);
 previousAB=(digitalRead(ENC_A)<<1)|digitalRead(ENC_B);
 SPI.begin(SCK_PIN,MISO_PIN,MOSI_PIN,-1);
 tft.initR(INITR_144GREENTAB);tft.setRotation(0);
 Serial.println(String("[SYSTEM] MakerVault v")+MAKERVAULT_FIRMWARE_VERSION+" / shared hardware SPI + Wi-Fi provisioning");
 splash();mvLoad();provisioningBegin();if(setupAPActive){page=SETUP_WIFI;render();}else home();lastInputAt=millis();
 Serial.println("[SYSTEM] Home menu ready; reader check deferred");
 Serial.println(String("[SYSTEM] READY v")+MAKERVAULT_FIRMWARE_VERSION);
}
void loop(){
 rbDispatch();rbBeginDispatch();
 if(rbBeginStatus==3){
  rbBeginStatus=0;
  regId=rbBeginId;regTarget=rbChosenName;regRecordCode=rbChosenCode;
  regLastCheck=millis();regState=1;regError="";
  if(rbBeginCancel){
   regCancel();page=RB_LIST;render();
  }else{
   page=REGISTRATION;scanResultVisible=false;lastPoll=0;render();
  }
 }else if(page==RB_PREVIEW){
  static uint8_t lastBeginState=255;
  if(lastBeginState!=rbBeginStatus){
   lastBeginState=rbBeginStatus;rbPreviewScreen();
  }
 }

 if(page==RB_LIST){
  static uint8_t rbLast=255;
  static uint32_t lastMarqueePaint=0;
  if(rbLast!=rbStatus){
   rbLast=rbStatus;rbListScreen();
  }else if(rbStatus==3 && rbCount &&
      (uint32_t)(millis()-lastMarqueePaint)>=190){
   lastMarqueePaint=millis();
   rbMarqueePaint();
  }
 }
 provisioningLoop();
 mvLoop();mvReconnectLoop();mvHeartbeatLoop();
 pendingWorkPoll(page==HOME || page==MAKERTAGS_MENU || page==RFID_MENU);
 regScheduleCancel();
 regScheduleProbe();
 scanLookupDispatch();
 if(page==SCAN && scanResultVisible && cfsDetected)cfsSpoolLookupDispatch();
 // Consolidated into pendingWorkPoll().
 regCheckStatus();
 regDispatchSubmit();
 regSubmissionWatchdog();
 if(regServerClosed && page==REGISTRATION){regReset();page=MAKERTAGS_MENU;render();}
 // Consolidated into pendingWorkPoll().
#if MAKERVAULT_NDEF_WRITER_ENABLED
 // Consolidated into pendingWorkPoll().
 opScheduleWatch();
 opDispatch();
 if((opState==1 || opState==13) && (page==HOME || page==MAKERTAGS_MENU)){
   page=TAG_OPERATION;lastPoll=0;render();
 }
 if(page==TAG_OPERATION){
   static uint8_t lastOpDrawn=255;
   if(lastOpDrawn!=opState){lastOpDrawn=opState;makerTagOperationScreen();}
 }

 // A previous verified or failed NFC request must not block the next
 // confirmed registration. Do not discard an active, unverified operation.
 if(regState==4 && regAutoWriteId.length()==36 &&
    (ndefState==6 || ndefState==7)) {
   Serial.printf("[NDEF] Clearing terminal NFC state %u before registration handoff\n",
                 (unsigned)ndefState);
   ndefReset(false);
 }
 if(regState==4 && regAutoWriteId.length()==36 && ndefState==0) {
   Serial.printf("[NDEF] Registration handoff granted for %s\n",regAutoTagId.c_str());
   // Registration was physically confirmed; continue the same operation.
   // Exact UID and URL are bound to the freshly created server write grant.
   ndefId=regAutoWriteId;ndefUid=regUid;ndefTagId=regAutoTagId;ndefUrl=regAutoUrl;
   ndefError="";ndefExistingUrl="";ndefForeignUrlOverride=false;ndefStarted=millis();ndefAutoFlow=true;ndefState=1;
   regReset();page=NDEF_WRITE;lastPoll=0;render();
 } else if(regState==4 && regAutoWriteId.length()==36 && ndefState!=0) {
   // Never claim success when another unverified NFC operation is active.
   // Expose the issue rather than leaving the registration screen stuck.
   Serial.printf("[NDEF] Registration handoff blocked by active state %u\n",
                 (unsigned)ndefState);
   regError="NFC busy; finish previous write";
   regState=5;
 }
 if(page==NDEF_WRITE && ndefState==10 && !mvTask){
  ndefState=2;
  if(!ndefConfirm()){
   // Do not consume the operator\'s approval merely because another
   // network operation briefly prevented the status check from starting.
   if(ndefState==2)ndefState=10;
  }
 }
 // Consolidated into pendingWorkPoll().
 ndefScheduleWatch();
 ndefScheduleCancel();
 ndefExpireLocal();
 if(ndefState==1 && page!=NDEF_WRITE && regState==0 && remoteLookupState==0){page=NDEF_WRITE;lastPoll=0;render();}
 if(page==NDEF_WRITE){static uint8_t shown=255;if(shown!=ndefState){shown=ndefState;ndefWriterScreen();}}
#endif
 if(remoteLookupState==1 && page!=LOOKUP_REQUEST && regState==0){page=LOOKUP_REQUEST;lastPoll=0;render();}
 if(page==LOOKUP_REQUEST){static uint8_t lastRemoteState=255;if(lastRemoteState!=remoteLookupState){lastRemoteState=remoteLookupState;remoteLookupScreen();}}
 if(regState==1 && page!=REGISTRATION){scanResultVisible=false;lastPoll=0;page=REGISTRATION;render();}
 if(page==REGISTRATION && regState==1){static uint32_t lastNamePage=UINT32_MAX;uint32_t currentNamePage=millis()/4000UL;if(currentNamePage!=lastNamePage){lastNamePage=currentNamePage;registrationScreen();}}
 if(page==REGISTRATION && (regState==2||regState==4||regState==5||regState==6||regState==7)){static uint8_t lastDrawn=0;static uint32_t lastReassignPage=UINT32_MAX;uint32_t reassignPage=millis()/4000UL;if(lastDrawn!=regState || (regState==6 && lastReassignPage!=reassignPage)){lastDrawn=regState;lastReassignPage=reassignPage;registrationScreen();}}
 processInputs();
 if(!readerInitDone && (uint32_t)(millis()-lastInputAt)>1100)readerInit();
 if(readerInitDone)pollTag();
 if(page==SCAN && scanResultVisible){static uint8_t lastScanLookup=255;static uint32_t lastScanPaint=0;if(lastScanLookup!=(cfsDetected?uint8_t(cfsLookupState+10+cfsMaterialLookupState*5):scanLookupState) || (scanLookupState==2 && millis()-lastScanPaint>4000)){lastScanLookup=cfsDetected?uint8_t(cfsLookupState+10+cfsMaterialLookupState*5):scanLookupState;lastScanPaint=millis();scanPage();}}
 if((uint32_t)(millis()-footerChecked)>250){footerChecked=millis();refreshFooter();
  if(page==MV_PAIR && mvPairState==2){static uint32_t prevSecond=0;uint32_t second=(millis()-mvPairStarted)/1000;if(second!=prevSecond){prevSecond=second;mvPairPage();}}
  if(page==MV_PAIR){
   static uint8_t drawnState=255,drawnCheck=255;static uint32_t pairedAt=0;
   if(drawnState!=mvPairState || (mvPairState==3 && drawnCheck!=mvCheckState)){
    drawnState=mvPairState;drawnCheck=mvCheckState;mvPairPage();
    pairedAt=(mvPairState==3&&mvCheckState==3)?millis():0;
   }
   if(pairedAt && (uint32_t)(millis()-pairedAt)>2300){pairedAt=0;page=MV_MENU;render();}
  }
 }
 // Repaint the connection page when a manual reconnect or background
 // verification changes status. Preserve the user's scroll position.
 if(page==MV_RECONNECT){
  static uint8_t displayedReconnect=255;
  uint8_t phase=mvReconnectState;
  if(displayedReconnect!=phase){displayedReconnect=phase;mvReconnectPage();}
 }
 if(page==MV_STATUS){
  static uint8_t lastMvStatusDrawn=255;
  static wl_status_t lastWifiStatusDrawn=WL_IDLE_STATUS;
  uint8_t state=mvCheckState;
  wl_status_t wifi=WiFi.status();
  if(lastMvStatusDrawn!=state || lastWifiStatusDrawn!=wifi){
   lastMvStatusDrawn=state;lastWifiStatusDrawn=wifi;
   mvStatusPage();
  }
 }
 if(page==MV_TLS_TEST){
  static uint32_t lastTestDrawn=0;
  if(lastTestDrawn!=mvTestCompleted){lastTestDrawn=mvTestCompleted;detailScroll=0;mvTlsTestPage();}
 }
 if(page==SETUP_WIFI && !setupAPActive){page=WIFI_MENU;render();}
 if(page==MAKERVAULT_SETUP && !setupPortalRunning()){page=MV_MENU;render();}
  memoryDiagnosticLoop();
  memoryRecoveryLoop();
}
