gavrd7/MakerVault-Hardware/firmware/rfid-terminal/MakerVault_Terminal_Firmware/ntag215_feature_gate.h

#pragma once
// MakerVault Terminal v0.7: NTAG215 NFC link writing is a standard feature.
// Runtime permission, UID, type, CC/lock, authorisation and read-back checks
// remain mandatory. Set to 0 only for an explicitly read-only custom build.
#ifndef MAKERVAULT_NDEF_WRITER_ENABLED
#define MAKERVAULT_NDEF_WRITER_ENABLED 1
#endif
