gavrd7/MakerVault-Hardware/firmware/rfid-terminal/MakerVault_Terminal_Firmware/ui_icons.h

#pragma once
#include <Arduino.h>
// RGB565 anti-aliased icons prepared for specific UI backgrounds.
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
