gavrd7/MakerVault-Hardware/firmware/rfid-terminal/MakerVault_Terminal_Firmware/scan_lookup.h

#pragma once
// Non-mutating MakerVault UID lookup for the existing normal Read tag screen.
// Uses only tags:read, verified HTTPS and the shared background task slot.
String scanLookupName="", scanLookupCode="", scanLookupError="";
volatile uint8_t scanLookupState=0; // 0 idle/offline, 1 checking, 2 found, 3 unknown, 4 error
uint32_t scanLookupSerial=0;
String scanLookupUid="", scanLookupKind="";
bool scanLookupQueued=false;

void scanLookupTask(void *) {
 String response;
 const uint32_t requestSerial=scanLookupSerial;
 String body=String("{\"kind\":\"")+scanLookupKind+"\",\"uid\":\""+scanLookupUid+"\"}";
 int status=mvHttps("/api/device/v1/tags/resolve/","POST",body,response,true);
 // An older request must never overwrite a newer displayed scan.
 if(requestSerial!=scanLookupSerial){mvTask=nullptr;vTaskDelete(nullptr);return;}
 if(status==200 && response.indexOf("\"found\": true")>=0 || (status==200 && response.indexOf("\"found\":true")>=0)) {
   int targetPos=response.indexOf("\"target\"");
   String targetSection=targetPos>=0?response.substring(targetPos):"";
   scanLookupName=mvField(targetSection,"label");
   scanLookupCode=mvField(response,"maker_tag_id");
   if(scanLookupName.isEmpty())scanLookupName=mvField(response,"label");
   scanLookupState=2;
 } else if(status==200) {
   scanLookupState=3;
 } else {
   scanLookupError=status==403?"Access denied":status==401?"Pair again":"Lookup unavailable";
   scanLookupState=4;
 }
 mvTask=nullptr;
 vTaskDelete(nullptr);
}

void scanLookupDispatch() {
 if(!scanLookupQueued || mvTask || scanLookupState!=1)return;
 if(!mvPairVerified || !mvCanReadTags || !mvEndpointApproved() || WiFi.status()!=WL_CONNECTED){
  scanLookupQueued=false;scanLookupState=4;scanLookupError="Lookup unavailable";return;
 }
 scanLookupQueued=false;
 if(xTaskCreatePinnedToCore(scanLookupTask,"mv_tag_lookup",12288,nullptr,1,&mvTask,0)!=pdPASS){
  mvTask=nullptr;scanLookupState=4;scanLookupError="Memory unavailable";
 }
}
void scanLookupBegin(const String &uid,const String &kind) {
 scanLookupSerial++;
 scanLookupQueued=false;scanLookupState=0;scanLookupName="";scanLookupCode="";scanLookupError="";
 if(!mvPairVerified||!mvCanReadTags||!mvEndpointApproved()||WiFi.status()!=WL_CONNECTED)return;
 scanLookupUid=uid;scanLookupKind=kind;
 scanLookupState=1;
 scanLookupQueued=true;
 scanLookupDispatch();
}
