gavrd7/MakerVault-Hardware/(commit log)

2026-10-23 docs: record verified terminal wiring and QR library requirement
2026-10-25 feat: add tested MakerVault RFID handheld firmware v0.5.1.13
    * docs: document v0.5.1 firmware integration and pairing contract
    * docs: document v0.5.1 firmware integration and pairing contract
    * vendor: include MIT-licensed QRCode source and attribution
    * vendor: include MIT-licensed QRCode source and attribution
    * vendor: include MIT-licensed QRCode source and attribution
    * docs: explain bundled MIT QRCode source and Arduino setup
    * docs: scope-aware terminal UI and revoked-device status acceptance criteria
    * docs: TLS diagnostics audit and physical acceptance cases
    * docs: record tested v0.5.1.13 source import and acceptance
    * docs: record tested v0.5.1.13 source import and accept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
2026-10-25 fix: align on-device and heartbeat version metadata to 0.5.1.14
    [MakerVault_v0523.ino]
2026-10-25 fix: align serial startup version with 0.5.1.14
    [MakerVault_v0523.ino]
2026-10-25 chore: AGPLv3 public-release preparation and Rev3 handheld CAD (#2)
    [MakerVault_flush_wordmark_3color_revC.3mf, button_cap_revD.step, button_cap_revD.stl, display_carrier_revC.step, display_carrier_revC.stl, encoder_knob_RevD.step, encoder_knob_RevD.stl, flush_bezel_black.step]
2026-10-28 Connected MakerTag terminal: lookup, registration, reassignment and recovery (#6)
    * feat: add background paired-terminal registration handoff client
    * feat: display pending Maker Tag assignments and require hardware Confirm
    * fix: prevent dismissed device registration request from reopening repeatedly
    * feat: constrain paired registration scanning to Type 2 and MIFARE Classic 1K families
    * docs: spell out NTAG215 and Classic 1K validation boundaries and physical tests
    * firmware: retrieve inventory or spool identifier alongside full record name
    * firmware: wrap Maker Tag record name and display inventory/spool ID
    * firmware: rotate wrapped long record names rather than truncate them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
    [MakerVault_Terminal_Firmware.ino, brand_images.h, connected_registration.h, maker_backend.h, provisioning.h, remote_lookup.h, scan_lookup.h, ui_icons.h]
2026-10-28 fix: centralize terminal firmware version for v0.6.1 (#8)
    * fix(firmware): report v0.6.0 in device heartbeat
    * fix: use shared firmware version in display and serial output
    * fix: centralize firmware version at v0.6.1
    * fix: use shared firmware version in authenticated heartbeat
    [MakerVault_Terminal_Firmware.ino, maker_backend.h]
2026-11-03 feat: start read-only CFS material decoding for MakerVault Terminal (#11)
    * feat: establish read-only CFS material sector parser and tests
    * feat: establish read-only CFS material sector parser and tests
    * feat: establish read-only CFS material sector parser and tests
    * fix: mirror CFS reader weight code mapping
    * test: align CFS sample fixture with source parser offsets
    * ci: test read-only CFS parser on pull requests
    * feat: add read-only MIFARE CFS sector authentication and AES decoding
    * feat: add read-only CFS spool UID lookup worker
    * feat: show decoded CFS tag material and read-only spool lookup on RFID scan
    * docs: describe integrated read-only CFS flow and remaining physica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
    [MakerVault_Terminal_Firmware.ino, bambu_tag_decoder.h, bambu_tag_reader.h, cfs_material_labels.h, cfs_spool_lookup.h, cfs_tag_decoder.h]
2026-11-04 feat: terminal MakerTag NFC clean and optional clean-on-remove (#159) (#12)
    * feat: add guarded NTAG215 NFC user-data clean primitive without record deletion
    * security: restrict NFC cleaning to original MakerTag short identity
    * test: verify MakerTag user-data erasure and fail-closed safety cases
    * test: make invalid MakerTag ID and post-wipe readback corruption deterministic
    * ci: run NTAG215 physical NFC wipe and existing writer policy fixtures
    * feat: add isolated paired-terminal clean/remove request state machine
    * fix: capture operation ID before asynchronous terminal cancellation
    * feat: add Clean/Remove MakerTag terminal menus, choices and status screens
    * feat: connect physi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
    [MakerVault_Terminal_Firmware.ino, connected_makertag_operation.h, connected_ndef_write.h, connected_registration.h, maker_backend.h, memory_recovery_policy.h, ntag215_clean.h]
